setiyadi-ben/Project-Tugas-Akhir/readme.md

<div style="text-align: justify">

# Politeknik Negeri Semarang ( Polines )
# Digital Library Skripsi/Tugas Akhir ( Thesis ), Sarjana Terapan S.Tr Teknik Telekomunikasi 

## Dikembangkan oleh Benny Hartanto Setiyadi
### Bermitra dengan :
- Giarto sebagai Owner dari Rumah Maggot Kabupaten Semarang.
- ~~Ngadiyono sebagai Kepala Bagian dari Rumah Maggot Kabupaten Semarang.~~
- Gunardi sebagai Penanggung Jawab dari Rumah Maggot Kabupaten Semarang.
### Dibawah bimbingan :
- Ari Sriyanto N., S.T., M.T., M.Sc., ( Dosen Pembimbing I ).
- Sindung H.W.S., B.S.E.E, M.Eng.Sc., ( Dosen Pembimbing II ).
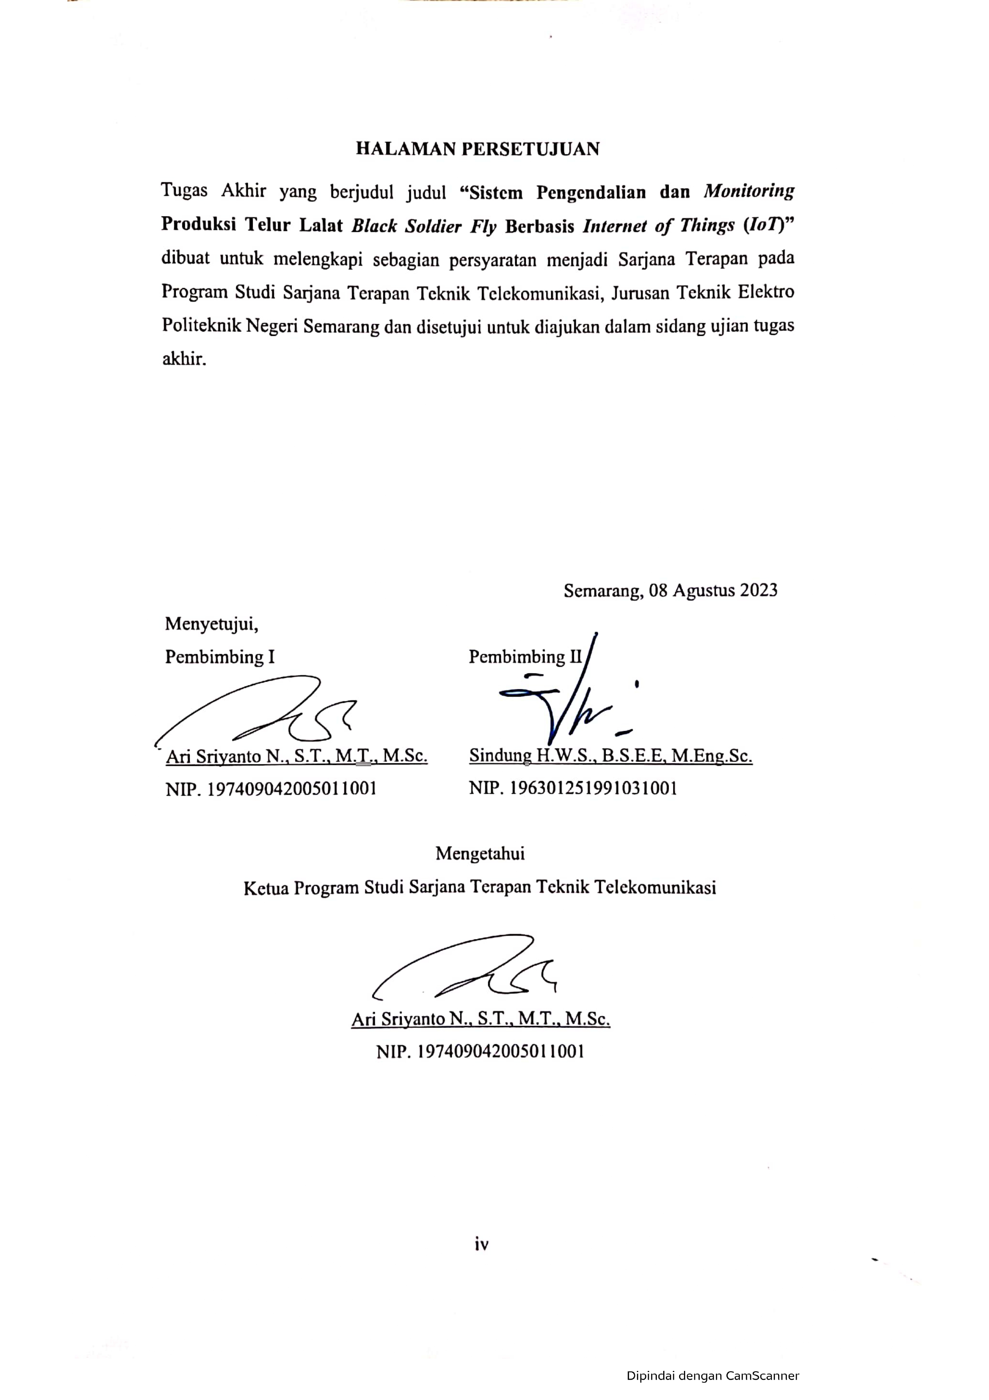
[picture p1: tugas_akhir/dokumenTA/Benny_TTD TA-2_persetujuan.jpg]


### Telah diuji oleh :
- Ir. Endro Wasito M. Kom ( Dosen Penguji I ).
- Drs. Arif Nursyahid, M.T ( Dosen Penguji II ).
- Abu Hasan, S.T., M.T ( Dosen Penguji III ).
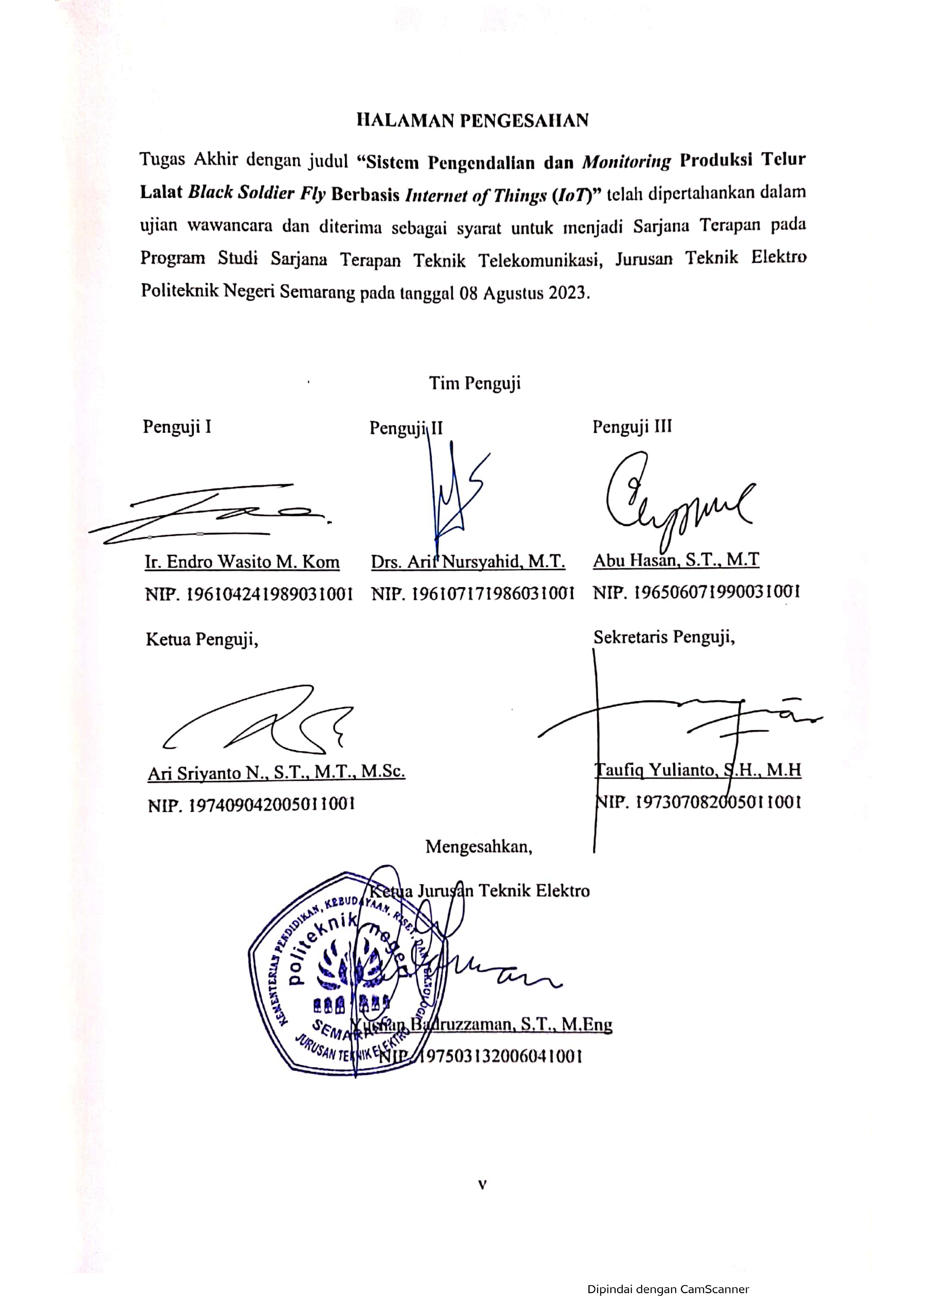
[picture p2: tugas_akhir/dokumenTA/Benny_TTD TA-3_pengesahan.jpg]


## Judul Tugas Akhir
  ### " Sistem Pengendalian dan Monitoring Produksi Telur Lalat Black Soldier Fly "

## Abstrak
<p align="justify"><i>
Benny Hartanto Setiyadi. “Sistem Pengendalian dan Monitoring Produksi Telur Lalat Black Soldier Fly Berbasis Internet of Things (IoT)”, Tugas Akhir Sarjana Terapan Teknik Telekomunikasi Jurusan Teknik Elektro Politeknik Negeri Semarang, dibawah bimbingan Ari Sriyanto N., S.T., M.T., M.Sc., dan Sindung H.W.S., B.S.E.E, M.Eng.Sc., 08 Agustus 2023, 54 Halaman. </p></i>
<p align="justify"><i>
Permasalahan sampah, termasuk sisa makanan, menjadi fokus penting di Indonesia dan negara lain. Pemerintah, terutama Kementerian Lingkungan Hidup dan Kehutanan, berupaya mengedukasi masyarakat dan Pengelola Tempat Pembuangan Akhir (TPA) untuk mengolah sampah sisa makanan menjadi pakan ternak alternatif. Larva lalat Black Soldier Fly (BSF) menawarkan potensi sebagai pengurai limbah sisa makanan yang efisien. Penelitian ini bertujuan merancang sistem IoT untuk mengendalikan dan memantau kondisi lingkungan kandang, dengan integrasi platform Telegram. Sistem ini mengontrol pompa air dan lampu fertilisasi, serta memiliki mode hybrid, yaitu manual menggunakan GPIO switch dan otomatis melalui bot Telegram. Dengan prototipe ini, penyemprotan air pada kandang lalat BSF dapat terjadwal secara otomatis melalui logika pemrograman pada bot Telegram, menghemat pemakaian air dibandingkan metode konvensional. Penggunaan aktuator lampu fertilisasi membantu lalat BSF beraktivitas normal saat intensitas cahaya rendah. Penelitian ini menggunakan metode Software Development Life Cycle model waterfall, meliputi tahap observasi, analisis kebutuhan, perancangan, implementasi, pengujian, dan analisis hasil. Hasil pengujian hardware membuktikan perangkat prototipe efektif mengendalikan aktuator secara manual dan otomatis melalui bot Telegram. Data hasil pengujian menunjukkan bahwa  rata – rata temperatur sebesar 32°C, kelembapan 60,8%, intensitas cahaya 15004lx menunjukkan standar lingkungan yang baik. Hasil dari telur yang diproduksi ialah berkisar dari 0,25 gram hingga 11 gram.</p></i>
<p align="justify"><i>
Kata kunci: Sampah Sisa Makanan, Lalat Black Soldier Fly, IoT, Telegram, Pengendalian Aktuator, Monitoring, Water pump, Lampu penyerbuk. </p></i>

## Dokumen Tugas Akhir :
Berikut merupakan dokumen - dokumen yang dibutuhkan pada saat membuat Tugas Akhir hingga dinyatakan selesai dan lulus hingga berhak untuk mengikuti wisuda pusat di Politeknik Negeri Semarang. 

<a href="/tugas_akhir/dokumenTA/daftarWisuda/[D4_TA]_BENNY HARTANTO S_TE4B_2023.pdf" target="_blank">`Laporan Tugas Akhir.pdf`</a> <a href="/tugas_akhir/dokumenTA/DIREVISI_LAPORAN_TA_BENNY2.docx" target="_blank">`Laporan Tugas Akhir.docx`</a> <a href="/tugas_akhir/dokumenTA/daftarWisuda/DIPAKAI_JURNAL_TA-ID.pdf" target="_blank">`Jurnal Tugas Akhir_ID.pdf`</a> <a href="/tugas_akhir/dokumenTA/daftarWisuda/DIPAKAI_JURNAL_TA-ID.docx" target="_blank">`Jurnal Tugas Akhir_ID.docx`</a> <a href="/tugas_akhir/dokumenTA/daftarWisuda/DIPAKAI_MANUALBOOK_TA.pdf" target="_blank">`Manualbook.pdf`</a>

<a href="/tugas_akhir/dokumenTA/Syarat Daftar Sidang.jpeg" target="_blank">`Syarat Daftar Sidang.jpeg`</a> <a href="/tugas_akhir/dokumenTA/Syarat Daftar Wisuda.jpeg" target="_blank">`Syarat Daftar Wisuda.jpeg`</a> <a href="/tugas_akhir/dokumenTA/Syarat mendapatkan SKL.pdf" target="_blank">`Syarat mendapatkan SKL/Transkrip.pdf`</a>

## Hasil Revisi Tugas Akhir :
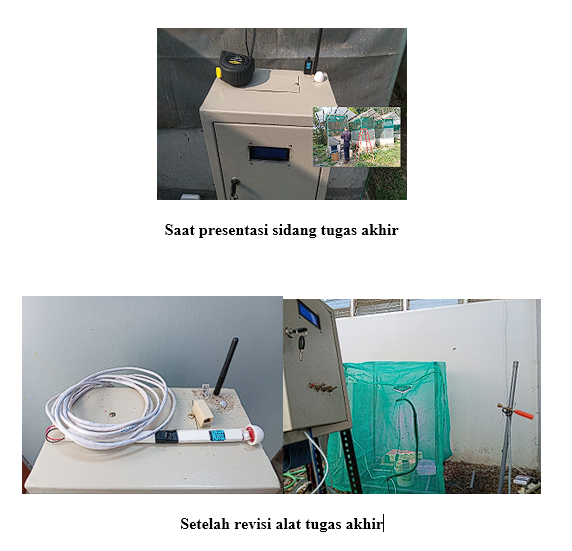
[picture p3: tugas_akhir/dokumenTA/hasilRevisi.png]


## Wiring Diagram

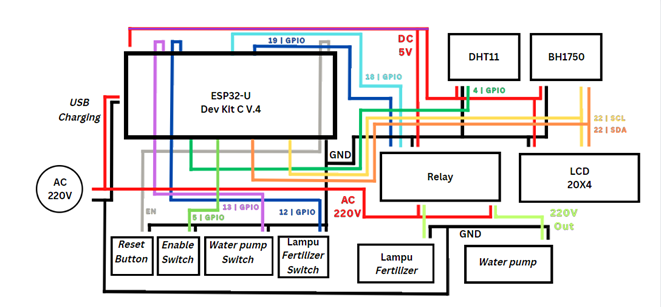
[picture p4: tugas_akhir/dokumenTA/wiringDiagram.png]

<!-- EMBED LOCAL FILE TIPS
https://www.seancdavis.com/posts/three-ways-to-add-image-to-github-readme/ -->

## Spesifikasi
- _Panel box dimensions_ (cm, cm, cm, cm).
- _Single_ 220VAC _power input splitted to_ ESP32, lampu _fertilizer_ dan _water pump_.
- 20x4 _LCD Display_.
- DHT11 _sensor_.
- BH1750 _sensor_.
- 2.4 GHz WiFi _antenna_ komunikasi.
- _Water pump_ 130PSi 12VDC dengan adapter AC.
- Lampu _fertilizer_ warna _bright purple_ dengan _female_ AC _jack_ 3 meter.
- _Manual GPIO Switch_ (_enable_, lampu _fertilizer_, _water pump_).
- _Reset Switch_

## Fitur - fitur :
- Mengendalikan kondisi _water pump_ ( LOW | HIGH ).
- Mengendalikan kondisi lampu _fertilizer_ ( LOW | HIGH ).
- Kendali _hybrid_ menggunakan perintah bot telegram maupun _Manual GPIO Switch_.
- Kendali kondisi otomatis melalui perintah _/schedule_ melalui bot telegram.
- _Monitoring_ suhu dan kelembapan melalui bot telegram dan layar _LCD_.
- _Monitoring_ intensitas cahaya melalui bot telegram dan layar _LCD_.
- Sistem dapat bekerja di saat internet putus sekalipun dengan syarat pada kondisi awal atau setelah reset pernah terhubung ke internet satu kali.

## Bugs :
- Saat koneksi internet _unstable_, terkadang akan memunculkan _duplicate messages_.
- ~~Saat proses _booting_, relay akan menyala di awal hingga program selesai dimuat (khusus untuk konfigurasi relay _Normally Close_ atau _NC_).~~
- Jika pesan balasan dari bot telegram lambat atau tidak muncul sama sekali perhatikan pada konfigurasi _antenna_ ESP32.
- Tidak bisa melayani request dalam jumlah banyak kecuali dengan cara bergantian.
- Tergantung dari kelancaran koneksi internet, _button_ kadang - kadang memerlukan 2 kali penekanan hingga dapat berfungsi.
- Perintah /schedule pada bot telegram kemungkinan akan terganggu jika koneksi WiFi terputus dikarenakan menggunakan sinkronisasi waktu _NTP_.
- ~~Masalah perintah _/switch_ pada bot telegram.~~
- ~~Masalah perintah _/schedule_ dimana aktuator tidak berhenti setelah perintah stop _button_ dijalankan.~~

## Playlist Video Sebelum Revisi (Klik Gambar dibawah)
<p align="center"><a href="https://www.youtube.com/playlist?list=PL8nDSUqXeZfUDnogHgag6RzNRzioCGDOZ">
  
</a></p>
<!-- EMBED YT PLAYLIST
https://bobbyhadz.com/blog/embed-video-into-github-readme-markdown -->

## Playlist Video Setelah Revisi (Klik Gambar dibawah)
<p align="center"><a href="https://www.youtube.com/playlist?list=PL8nDSUqXeZfWEAUHO0MUWcxwX7mzMBE_k">
  
</a></p>

## Requirements and How to Set-Up

**Saya anggap siapapun yang akan mencoba mempraktikkan atau berniat menggunakan kode ini sepenuhnya sadar dan memahami tentang pengkabelan jalur kabel seperti yang tertera pada _Wiring Diagram_, cara menggunakan Visual Studio Code beserta dengan ekstensi PlatformIO. Jika sudah, ikutilah langkah singkat dibawah ini atau bisa dengan membuka manualbook yang tertera di dokumen TA.**

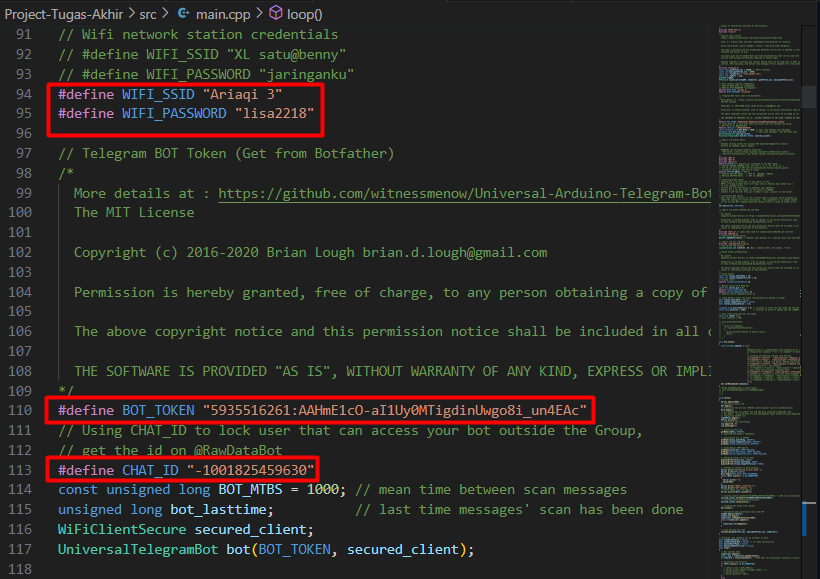
[picture p5: tugas_akhir/dokumenTA/setup.png]
pengabelan


Ubahlah parameter WIFI_SSID dan WIFI_PASSWORD sesuai dengan jaringan kalian. Kemudian juga pada BOT_TOKEN dan CHAT_ID, jika bertanya bagaimana? Kalian dapat mencarinya di Youtube sendiri terima kasih.

</div>
