setiyadi-ben/Project-Tugas-Akhir/tugas_akhir/datasheetKomponen/NOTES.txt

UNI-T 383 : 
- (DEMO VIDEO) https://www.youtube.com/watch?v=1Zy0yAb8VEA&t=86s
- (STORE PAGE) https://id.aliexpress.com/item/1005003141560128.html?
- (WEBSITE) https://meters.uni-trend.com/product/ut383-ut383bt/#Specifications

SMART SENSOR AS803 :
- (DEMO VIDEO) https://www.youtube.com/watch?v=disgpO15m7I
- (STORE PAGE) https://id.aliexpress.com/item/32792380083.html?
- (WEBSITE) https://en.smartsensor.cn/product/52.html
