setiyadi-ben/Project-Tugas-Akhir/tugas_akhir/dokumenTA/Pengumpulan Alat TA Fisik.docx

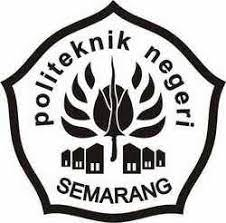
[picture p203: figure]

| PENGUMPULAN BENDA JADI ALAT TUGAS AKHIR | No. PM
| | Revisi
| | Tanggal
| | Halaman

N A M A KELAS NIM | : Benny Hartanto Setiyadi : TE-4B : 4.39.19.0.06 | JUDUL TUGAS AKHIR : “Sistem Pengendalian dan Monitoring Produksi Telur Lalat Black Soldier Fly” PETUNJUK PENGGUNAAN : - Manual book - Online repo : https://github.com/setiyadi-ben/Project-Tugas-Akhir
