setiyadi-ben/Project-Tugas-Akhir/tugas_akhir/dokumenTA/DIUPLOAD-DIREVISI_LAPORAN_TA_BENNY2.pdf

TUGAS AKHIR

SISTEM PENGENDALIAN DAN MONITORING

PRODUKSI TELUR LALAT BLACK SOLDIER FLY

BERBASIS INTERNET OF THINGS (IoT)

Tugas Akhir ini diajukan untuk memenuhi persyaratan untuk menjadi

Sarjana Terapan pada Program Studi S.Tr Teknik Telekomunikasi

Jurusan Teknik Elektro Politeknik Negeri Semarang


Disusun oleh :

BENNY HARTANTO SETIYADI

4.39.19.0.06

PROGRAM STUDI SARJANA TERAPAN TEKNIK TELEKOMUNIKASI

JURUSAN TEKNIK ELEKTRO

POLITEKNIK NEGERI SEMARANG

2023

ii

TUGAS AKHIR

SISTEM PENGENDALIAN DAN MONITORING

PRODUKSI TELUR LALAT BLACK SOLDIER FLY

BERBASIS INTERNET OF THINGS (IoT)

Tugas Akhir ini diajukan untuk memenuhi persyaratan untuk menjadi

Sarjana Terapan pada Program Studi S.Tr Teknik Telekomunikasi

Jurusan Teknik Elektro Politeknik Negeri Semarang

Disusun oleh :

BENNY HARTANTO SETIYADI

4.39.19.0.06

PROGRAM STUDI SARJANA TERAPAN TEKNIK TELEKOMUNIKASI

JURUSAN TEKNIK ELEKTRO

POLITEKNIK NEGERI SEMARANG

2023

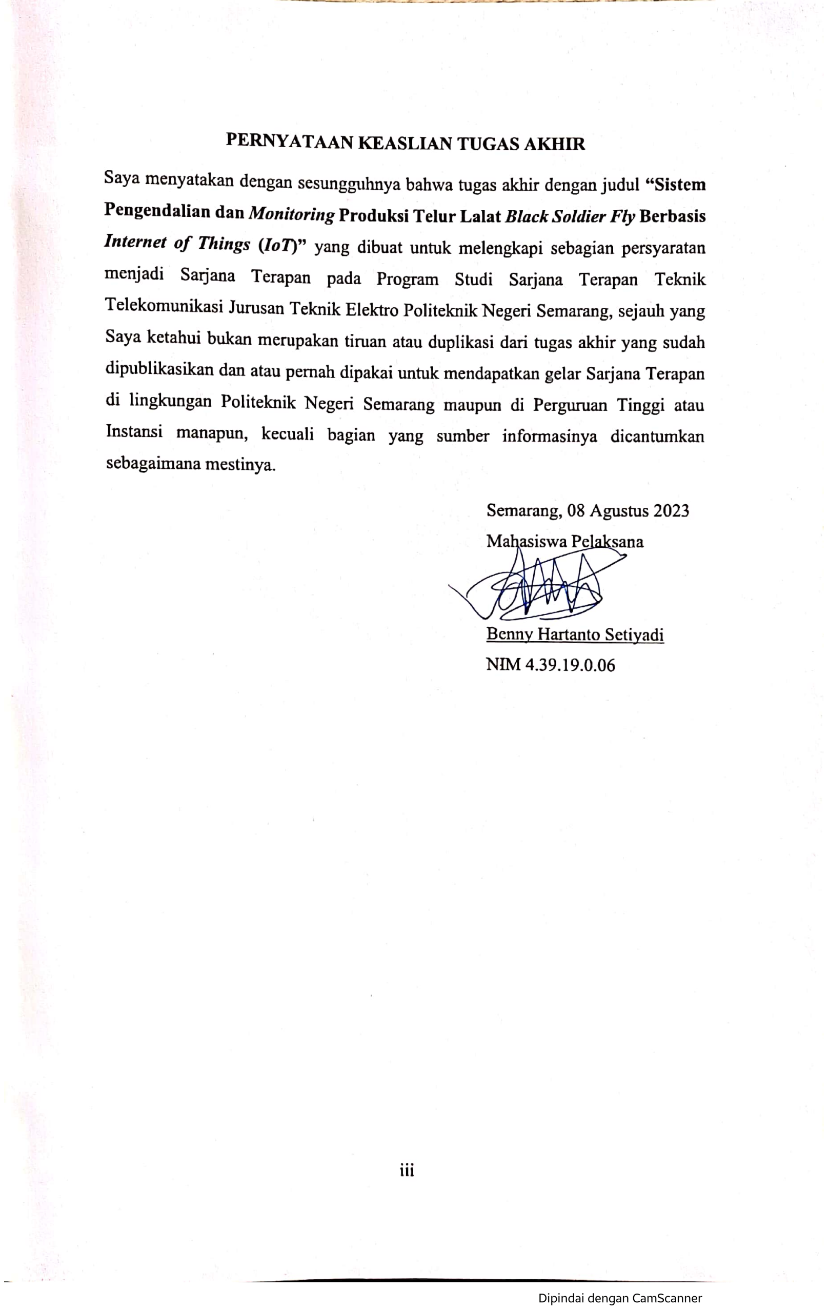
[picture p264: page 3]
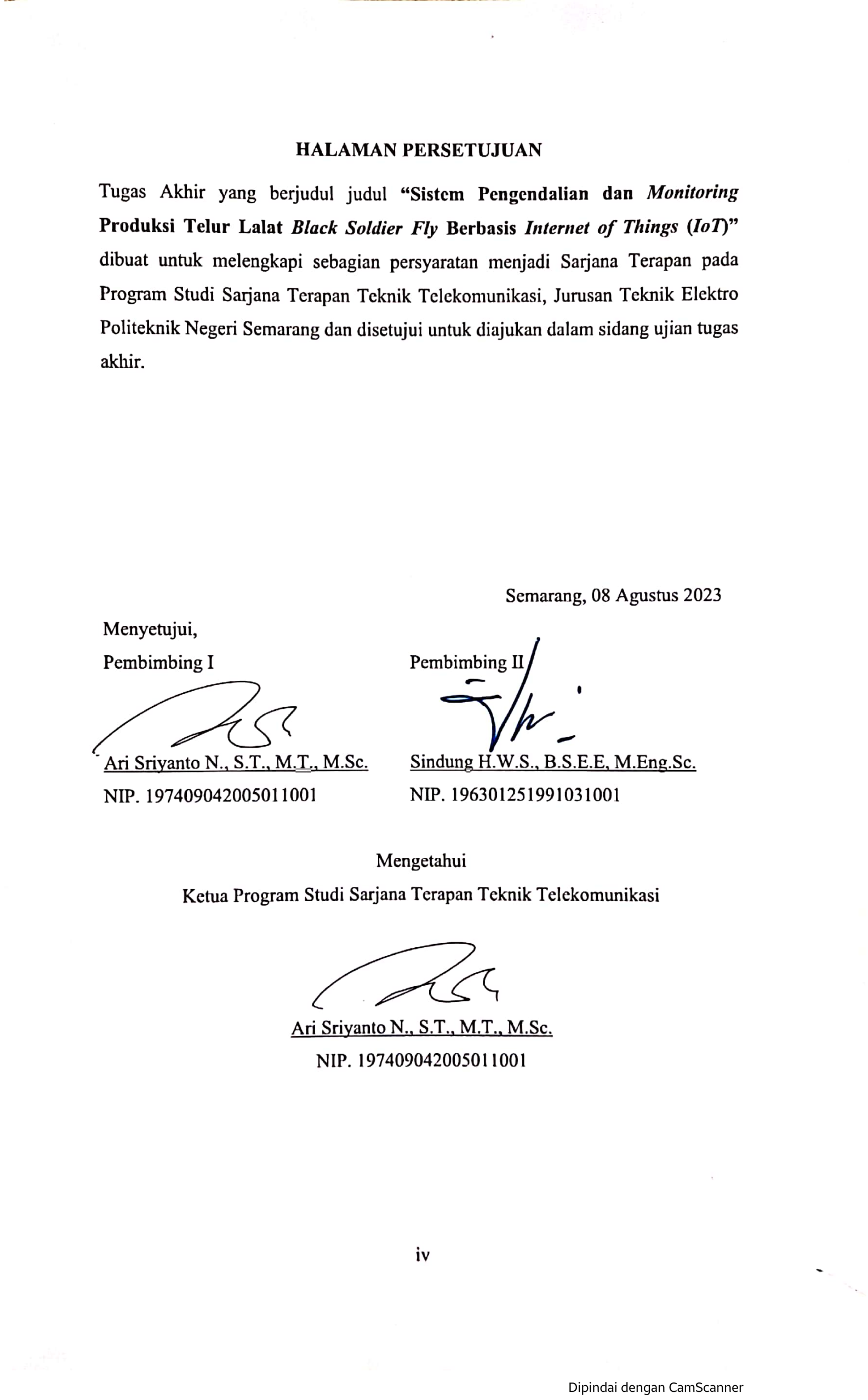
[picture p265: page 4]
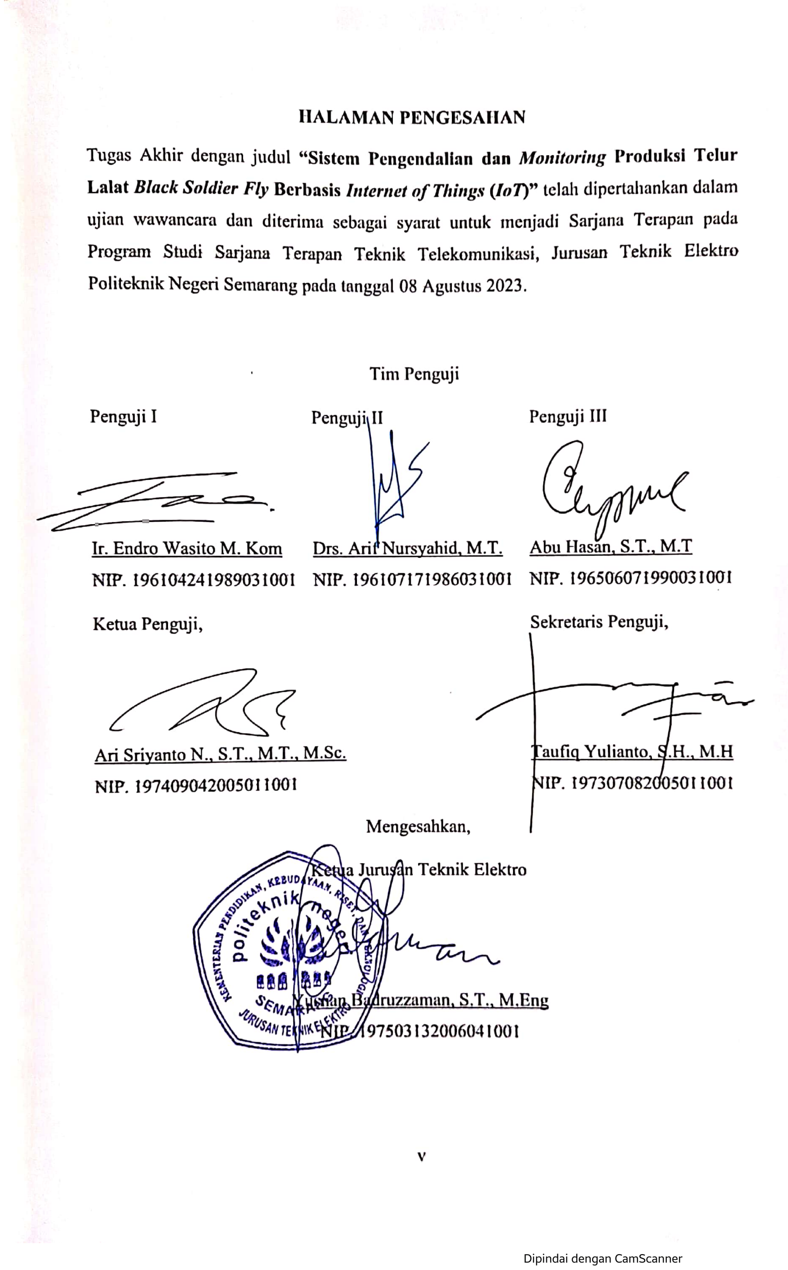
[picture p266: page 5]

vi

KATA PENGANTAR

Puji syukur kehadirat Tuhan Yang Maha Esa, yang telah memberikan rahmat dan

hidayah-Nya sehingga penulis dapat menyelesaikan tugas akhir dengan judul

“Sistem Pengendalian dan Monitoring Produksi Telur Lalat Black Soldier Fly

Berbasis Internet of Things (IoT)” tugas akhir ini merupakan salah satu

persyaratan untuk menjadi Sarjana Terapan pada Program Studi S.Tr Teknik

Telekomunikasi Jurusan Teknik Elektro Politeknik Negeri Semarang.

Dalam pelaksanaan dan penyelesaian laporan tugas akhir ini penulis dibantu oleh

banyak pihak. Oleh karena itu, penulis mengucapkan terima kasih kepada :

1. Allah SWT.
2. Bapak Prof., Dr., Totok Prasetyo., B.Eng (Hons)., MT., IPU.,

ASEAN.Eng., ACPE., selaku Direktur Politeknik Negeri Semarang.

3. Bapak Yusnan Badruzzaman, S.T., M.Eng., selaku Ketua Jurusan Teknik

Elektro.

4. Bapak Ari Sriyanto N., S.T., M.T., M.Sc., selaku Ketua Prodi S.Tr Teknik

Telekomunikasi dan merangkap menjadi Pembimbing I yang telah banyak

berjasa, membantu, mendukung penuh dan membimbing Saya dalam

menyelesaikan tugas akhir ini.

5. Bapak Sindung H.W.S., B.S.E.E, M.Eng.Sc., selaku Pembimbing II yang

telah banyak berjasa, membantu, mendukung penuh dan membimbing

Saya dalam menyelesaikan tugas akhir ini.

6. Bapak, Ibu dosen, dan staff teknik Prodi S.Tr Teknik Telekomunikasi

Politeknik Negeri Semarang.

7. Bapak, Ibu, dan semua keluarga Penulis yang selalu memberikan dukungan

dan doa yang tulus.

8. Teman beserta sahabat yang melakukan studi didalam Prodi S.Tr Teknik

Telekomunikasi Politeknik Negeri Semarang angkatan 2019.

Semarang, 08 Agustus 2023

Penulis

vii

ABSTRAK

Benny Hartanto Setiyadi. “Sistem Pengendalian dan Monitoring Produksi Telur

Lalat Black Soldier Fly Berbasis Internet of Things (IoT)”, Tugas Akhir Sarjana

Terapan Teknik Telekomunikasi Jurusan Teknik Elektro Politeknik Negeri

Semarang, dalam bimbingan Ari Sriyanto N., S.T., M.T., M.Sc., dan Sindung

H.W.S., B.S.E.E, M.Eng.Sc., 08 Agustus 2023, 54 Halaman.

Permasalahan sampah, termasuk sisa makanan, menjadi fokus penting di Indonesia dan negara

lain. Pemerintah, terutama Kementerian Lingkungan Hidup dan Kehutanan, berupaya mengedukasi

masyarakat dan Pengelola Tempat Pembuangan Akhir (TPA) untuk mengolah sampah sisa

makanan menjadi pakan ternak alternatif. Larva lalat Black Soldier Fly (BSF) menawarkan potensi

sebagai pengurai limbah sisa makanan yang efisien. Penelitian ini bertujuan merancang sistem IoT

untuk mengendalikan dan memantau kondisi lingkungan kandang, dengan integrasi platform

Telegram. Sistem ini mengontrol pompa air dan lampu fertilisasi, serta memiliki mode hybrid, yaitu

manual menggunakan GPIO switch dan otomatis melalui bot Telegram. Dengan prototipe ini,

penyemprotan air pada kandang lalat BSF dapat terjadwal secara otomatis melalui logika

pemrograman pada bot Telegram, menghemat pemakaian air dibandingkan metode konvensional.

Penggunaan aktuator lampu fertilisasi membantu lalat BSF beraktivitas normal saat intensitas

cahaya rendah. Penelitian ini menggunakan metode Software Development Life Cycle model

waterfall, meliputi tahap observasi, analisis kebutuhan, perancangan, implementasi, pengujian, dan

analisis hasil. Hasil pengujian hardware membuktikan perangkat prototipe efektif mengendalikan

aktuator secara manual dan otomatis melalui bot Telegram. Data hasil pengujian menunjukkan

bahwa rata – rata temperatur sebesar 32°C, kelembapan 60,8%, intensitas cahaya 15004lx

menunjukkan standar lingkungan yang baik. Hasil dari telur yang diproduksi ialah berkisar dari

0,25 gram hingga 11 gram.

Kata kunci: Sampah Sisa Makanan, Lalat Black Soldier Fly, IoT, Telegram,

Pengendalian Aktuator, Monitoring, Water pump, Lampu penyerbuk.

viii

ABSTRACT

Benny Hartanto Setiyadi. "Control and Monitoring System for Black Soldier Fly

Egg Production based on Internet of Things (IoT)," Undergraduate Thesis in

Applied Telecommunication Engineering, Department of Electrical Engineering,

State Polytechnic of Semarang, under the guidance of Ari Sriyanto N., S.T., M.T.,

M.Sc., and Sindung H.W.S., B.S.E.E, M.Eng.Sc., August 08, 2023, 54 Pages.

The issue of waste, including food scraps, is a significant concern in Indonesia and other countries.

The government, particularly the Ministry of Environment and Forestry, strives to educate the public

and Waste Disposal Site Managers (TPA) about converting food waste into alternative animal feed.

Larvae of the Black Soldier Fly (BSF) offer the potential for efficient decomposition of food waste.

This research aims to design an IoT system to control and monitor the environmental conditions

inside the breeding chamber, utilizing the waterfall model in the Software Development Life Cycle.

The system controls the water pump and fertilization lamp, with hybrid modes available: manual

operation via GPIO switch and automatic operation through the Telegram bot. With this prototype,

automated scheduling of water spraying in the BSF chamber is achieved using Telegram's

programming logic, resulting in water conservation compared to conventional methods. The use of

the fertilization lamp actuator aids in maintaining normal BSF activity under low light conditions.

This study employs the Software Development Life Cycle waterfall model, encompassing stages of

observation, requirement analysis, design, implementation, testing, and result analysis. Hardware

testing results demonstrate the prototype device's effectiveness in manually and automatically

controlling actuators through the Telegram bot. Test data indicates an average temperature of 32°C,

humidity of 60.8%, and light intensity of 15004lx, signifying a satisfactory environmental standard.

The produced egg yields range from 0.25 grams to 11 grams..

Keywords: Food Scraps, Black Soldier Fly, IoT, Telegram, Actuator Control,

Monitoring, Fertilizer Light.

ix

DAFTAR ISI

x

xi

DAFTAR GAMBAR

Gambar 1.1 Metode SDLC model waterfall pada penelitian tugas akhir (Sumber :

Gambar 2.1 Lalat Black Soldier Fly (Sumber : Dinas Pertanian dan Ketahanan

Gambar 2.2 Siklus Hidup Lalat Black Soldier Fly (Sumber : Tomberlin et al.

Gambar 2.3 The Botfather, layanan untuk membuat dan mengelola akun bot

Gambar 2.4 ESP32 Mikrokontroler dengan external antenna (Sumber :

Gambar 2.5 Sensor BH1750 (Sumber : https://tokopedia.link/wxJ0pAOjsub).... 14

Gambar 2.6 Digital Lux Light Meter (Sumber :

Gambar 2.7 Sensor DHT11 (Sumber : https://tokopedia.link/hOzuF1Cosub) ..... 16

Gambar 2.8 Alat ukur temperatur (Sumber :

https://www.tokopedia.com/anugerahmed-mlg/thermometer-hygrometer-digital-

Gambar 2.9 Alat ukur temperatur (Sumber :

Gambar 2.17 Grow Light (Sumber:

xii

Gambar 3.3 Mekanisme sistem dalam flowchart bagian – 1 (Dok. Penulis)........ 25

Gambar 3.4 Mekanisme sistem dalam flowchart bagian – 2 (Dok. Penulis)........ 26

Gambar 3.6 Simulasi program menggunakan koneksi serial (Dok. Penulis) ....... 28

Gambar 3.11 Hasil rancang bangun perangkat prototipe sistem IoT (Dok. Penulis)

Gambar 3.14 Perangkat terkendali water pump pada perangkat prototipe (Dok.

Gambar 3.16 Aplikasi penggunaan bot telegram bagian – 1 (Dok. Penulis)........ 34

Gambar 3.14 Aplikasi penggunaan bot telegram bagian – 2 (Dok. Penulis)........ 34

Gambar 3.15 Aplikasi penggunaan bot telegram bagian – 3 (Dok. Penulis)........ 35

Gambar 3.16 Aplikasi penggunaan bot telegram bagian – 4 (Dok. Penulis)........ 35

Gambar 4.5 Pemantauan realtime cuaca dengan pancaindra (Dok. Pengujian

Gambar 4.6 Jumlah produksi telur dalam satuan miligram (Dok. Pengujian

Gambar 4.7 Balok kayu tempat lalat BSF bertelur (Dok. Pengujian Penulis)...... 48

xiii

DAFTAR TABEL

Tabel 4.5 Pengujian lapangan atau field testing tanpa interaksi oleh perangkat

Tabel 4.6 Pengujian lapangan atau field testing dengan interaksi oleh perangkat

BAB I

PENDAHULUAN

### 1.1. Latar Belakang

Permasalahan mengenai sampah merupakan sebuah permasalahan yang dialami

oleh semua negara baik negara maju maupaun negara berkembang seperti

contohnya Indonesia. Menurut Undang-Undang Republik Indonesia Nomor 18

Tahun 2008 Tentang Pengelolaan Sampah, yang dimaksud sampah adalah sisa

kegiatan sehari-hari manusia dan/atau proses alam yang berbentuk padat. Sampah

ini dihasilkan manusia setiap melakukan aktivitas sehari-hari.

Adapun jenis sifat sampahnya, dapat dikategorikan menjadi 2 yaitu, sampah

organik dan sampah anorganik. Sampah organik merupakan sampah yang dapat

membusuk dan dapat terurai oleh lingkungan dengan bantuan hewan maupun

serangga pengurai. Sedangkan, sampah anorganik tidak dapat terurai oleh

lingkungan dengan cara yang sesingkat sampah organik, sampah ini membutuhkan

waktu ribuan tahun hingga dapat terurai menjadi tanah. Oleh sebab itu, sampah

anorganik harus dikumpulkan untuk diolah kembali (didaur ulang) menjadi benda

yang sama atau menjadi benda berbeda yang dapat digunakan kembali oleh

manusia.

Berdasarkan data dari Kementerian Lingkungan Hidup dan Kehutanan (KLHK)

mencatat, Indonesia menghasilkan sampah sebanyak 21,88 juta ton pada 2021.

Jumlah itu menurun 33,33% dibandingkan pada tahun sebelumnya yang sebanyak

32,82 juta ton. Kondisi tersebut berbeda dengan tahun 2020 yang jumlah

sampahnya justru meningkat 12,63%. Sementara, jumlah timbulan sampah pada

2019 sebanyak 29,14 juta ton. Berdasarkan wilayahnya, Jawa Tengah menjadi

provinsi dengan sampah terbesar di Indonesia pada 2021, yakni 3,65 juta ton.

Posisinya disusul oleh Jawa Timur dengan sampah sebanyak 2,64 juta ton (Mahdi

& Bayu, 2021).

Menurut data dari SIPSN (Sistem Informasi Pengelolaan Sampah Nasional) pada

tahun 2021, diketahui bahwa komposisi jenis sampah terbesar disumbang oleh jenis sisa makanan sebesar 40.1% kemudian disusul oleh plastik 17.5%, kayu 13%,

kertas 11.9% dan 17.5% jenis sampah lainnya (SIPSN, 2022).

Dengan begitu banyaknya sampah dari jenis sisa makanan ini menjadi fokus

penting Pemerintah khususnya Kementerian Lingkungan Hidup dan Kehutanan

(KLHK) dalam mengedukasikan solusi kepada para masyarakat umum maupun

Pengelola Tempat Pembuangan Akhir (TPA) untuk mengolah sampah sisa

makanan tersebut menjadi produk organik yang dapat dimanfaatkan sebagai sumber

pakan ternak alternatif.

Adapun sumber pakan ternak yang dimaksud adalah larva atau maggot dari

serangga Lalat Black Soldier Fly atau BSF (dalam bahasa latin: Hermetia illucens

L) atau yang sering disebut dengan lalat tentara hitam. Lalat BSF ini mampu

mengurai limbah sisa makanan dalam waktu beberapa hari saja tergantung dengan

berapa besar kandang tempat lalat tersebut ditempatkan. Saat menuju fase prepupa

hingga menjadi lalat BSF dewasa, lalat tersebut akan berhenti makan dan lalat

tersebut akan mati setelah selesai bereproduksi (kawin) untuk lalat pejantan dan

mati setelah bertelur untuk lalat betina.

Pada saat fase reproduksi didapatkan bukti bahwa terdapat lalat yang sudah mati

lebih awal sebelum melakukan kegiatan reproduksi. Hal ini secara umum

disebabkan oleh 2 faktor penting yaitu, lalat yang tidak mendapatkan minum secara

rutin dikarenakan mereka sudah berhenti makan dan hanya meminum partikel air

di fase prepupa ditambah dengan faktor kesediaan intensitas cahaya sinar cahaya

matahari yang kurang cerah menyebabkan kegiatan lalat BSF dalam melakukan

proses reproduksi berkurang. Dijelaskan bahwa panjang gelombang 450-700 nm

berpengaruh terhadap tingkah laku kawin lalat BSF, sedangkan pada panjang

gelombang 350-450 nm tidak menstimulasi terjadinya aktivitas kawin BSF.

Panjang gelombang cahaya yang masih dapat dilihat oleh inseksta sekitar 700 nm

(Briscoe & Chittka, 2001).

Permasalahan berupa penyediaan air minum dan penyediaan intensitas cahaya

inilah yang menjadi fokus penting dalam pembuatan suatu sistem yang dapat

menyelesaikan kebutuhan dari lalat BSF untuk melakukan kegiatan reproduksi.

Dengan kata lain teknologi tersebut diharapkan mampu untuk secara otomatis maupun manual untuk dikonfigurasi (bersifat hybrid) menggunakan smartphone

melalui jaringan internet agar nantinya dapat menyediakan kondisi lingkungan di

dalam kandang yang ideal. Sehingga, lalat BSF dapat menghasilkan jumlah telur

dengan lebih baik jika dibandingkan dengan cara konvensional.

Internet of Things (IoT) merupakan sebuah konsep di mana suatu benda atau objek

ditanamkan teknologi-teknologi seperti sensor dan software dengan tujuan untuk

berkomunikasi, mengendalikan, menghubungkan, dan bertukar data melalui

perangkat lain selama masih terhubung ke internet. IoT memiliki hubungan yang

erat dengan istilah machine-to-machine atau M2M. Seluruh alat yang memiliki

kemampuan komunikasi M2M ini sering disebut dengan perangkat cerdas atau

smart devices. Perangkat cerdas ini diharapkan dapat membantu kerja manusia

dalam menyelesaikan berbagai urusan atau tugas yang ada (Setiawan, 2021b).

### 1.2. Tujuan

Adapun tujuan dari pembuatan tugas akhir ini adalah :

1. Membuat rancang bangun sistem IoT untuk pengendalian dan monitoring

produksi telur lalat BSF pada kandangnya dengan integrasi platform telegram.

2. Rancang bangun sistem tersebut dapat mengendalikan kondisi water pump.
3. Rancang bangun sistem tersebut dapat mengendalikan kondisi lampu fertilizer.
4. Rancang bangun sistem tersebut bersifat hybrid yang artinya memiliki

kemampuan untuk bertransisi dari manual mode ke automatic mode dan

sebaliknya.

### 1.3. Perumusan Masalah

Dari berbagai tujuan di atas, dapat dijadikan sebagai landasan untuk menyelesaikan

masalah berupa :

1. Bagaimana membuat sistem pengendalian dan monitoring untuk kandang lalat

BSF yang dapat mengendalikan kondisi water pump dan lampu fertilizer

terintegrasi oleh platform telegram dengan kemampuan hybrid.

### 1.4. Batasan Masalah

Dari pembuatan tugas akhir ini, fokus yang dapat dijadikan sebagai pedoman

pengentasan masalah berupa :

1. Topik dari tugas akhir ini akan berfokus pada lalat BSF dewasa yang memasuki

masa reproduksi hingga bertelur mengenai metode perawatan yang akan

dikendalikan oleh sistem yang akan dibuat.

2. Produk yang dihasilkan akan berupa sebuah prototipe yang bersifat hybrid agar

dapat dikonfigurasi baik secara otomatis maupun manual.

3. Permintaan dari user yang menginginkan agar sistem yang dibuat agar dapat

mudah dikendalikan bahkan pada saat kondisi internet terputus.

4. Adapun parameter yang dapat dikonfigurasi berupa air pada water pump dan

cahaya pada lampu fertilizer

5. Adapun prototipe tersebut akan berbentuk sebuah panel box yang terdiri dari

rangkaian komponen elektronika dengan ESP32 sebagai otaknya, DHT11 dan

BH1750 sebagai sensor, sedangkan relay sebagai aktuator yang mengatur

perangkat terkendali water pump dan lampu fertilizer.

6. Khusus untuk sensor BH1750 hanya akan digunakan sebagai pendeteksi naik

dan turunnya nilai intensitas cahaya untuk merubah kondisi perangkat

terkendali lampu fertilizer. Dikarenakan hasil dari pembacaan sensor readings

memiliki standarisasi penilaian yang berbeda dengan alat ukur mini light meter

membuat nilai yang dihasilkan memiliki selisih nilai yang acak dan tidak

beragam.

7. Prototipe tersebut terhubung dengan bot pada platform telegram yang hanya

dapat diakses oleh pengguna telegram yang bergabung pada grup “Maggot BSF

Kab. Semarang” sebagai upaya preventif dari serangan oleh pihak yang tidak

bertanggungjawab.

### 1.5. Metodologi Penelitian

Metode penelitan yang digunakan dalam penyusunan tugas akhir ini yaitu metode

penelitian Software Development Life Cycle model waterfall. Metode SDLC sendiri

adalah proses pembuatan dan pengubahan sistem serta model dan metodologi yang

digunakan untuk mengembangkan sistem rekayasa perangkat lunak dalam pengembangan produk. Sedangkan model waterfall adalah metode kerja yang

menekankan fase-fase yang berurutan dan sistematis. Disebut waterfall karena

proses mengalir satu arah “ke bawah” seperti air terjun. Metode waterfall ini harus

dilakukan secara berurutan sesuai dengan tahap yang ada (Setiawan, 2021a).

Alur dari penelitian tugas akhir dapat digambarkan pada gambar 1.1 sebagai berikut

:


Gambar 1.1 Metode SDLC model waterfall

pada penelitian tugas akhir (Sumber : Dok. Penulis)

Berikut ini merupakan penjelasan dari alur SDLC model waterfall :

1. Observasi

Kegiatan dilakukan dengan cara kunjungan secara langsung dengan mengamati

kondisi lingkungan budidaya lalat BSF di tempat user atau mitra usaha di TPA

Blondo, Kabupaten Semarang untuk mengumpulkan data – data yang

diperlukan pada pembuatan tugas akhir.

2. Analisa Kebutuhan

Tahapan ini merupakan kelanjutan dari proses observasi untuk merencanakan

beberapa hal yang terkait dengan kebutuhan yang diinginkan oleh user,

teknologi yang akan dipakai, anggaran yang dikeluarkan dan lain – lain.

3. Perancangan

Pada tahap perancangan, penerapan teknologi diterapkan mulai dari arsitektur

sistem secara keseluruhan yang didalamnya arsitektur hardware yang

didalamnya terdapat rangkaian komponen elektronika yang digambarkan dalam

wiring diagram beserta flowchart dan arsitektur software yang menjelaskan

bagaimana sistem dapat beroperasi dan melakukan komunikasi dengan platform

telegram agar dapat dikonfigurasi.

4. Implementasi

Tahapan ini merupakan penerapan dari tahap perancangan dimana setiap model

– model rancangan dikerjakan hingga membentuk sebuah perangkat prototipe

yang dapat dioperasikan secara hybrid.

5. Uji lapangan

Pengujian pada lapangan untuk membuktikan keandalan sistem pada perangkat

prototipe beserta keakuratan pembacaan sensor readings untuk dibandingkan

dengan kondisi awal pemanenan telur lalat BSF tanpa interaksi perangkat

prototipe.

6. Analisis Hasil

Merupakan tahapan akhir dimana data – data hasil pengujian yang telah

dilakukan pada tahap uji lapangan dilakukan proses interpretasi untuk

memperoleh jawaban dalam bentuk ilmiah yang mudah dipahami, dapat

dipertanggung jawabkan serta dapat disimpulkan.

### 1.6. Sistematika Penulisan

Dalam penyusunan tugas akhir ini dilakukan pengelompokkan menurut isi dalam

beberapa bab. Bagian yang dapat berdiri sendiri dipisahkan dengan bagian yang

lain dan ditempatkan dalam bab tersendiri dengan maksud mempermudah

pemahaman. Adapun sistematika penulisannya adalah sebagai berikut:

BAB I : PENDAHULUAN

Bab I Pendahuluan berisi tentang latar belakang, perumusan masalah, manfaat,

tujuan yang diharapkan, batasan masalah dan sistematika penulisan laporan tugas

akhir.

BAB II : TINJAUAN PUSTAKA

Bab II Tinjauan Pustaka berisi tentang penjelasan mengenai teori–teori penunjang

yang dijadikan landasan dalam mengerjakan tugas akhir.

BAB III : KEGIATAN PELAKSANAAN

Bab III Kegiatan Pelaksanaan berisi tentang tahap perancangan, tahap pembuatan,

dan cara kerja alat yang dibuat.

BAB IV : ANALISIS DAN PEMBAHASAN

Bab IV Analisis dan Pembahasan berisi tentang pembahasan hasil percobaan, serta

pembahasan analisa hasil percobaan.

BAB V : KESIMPULAN

Bab V Kesimpulan berisi tentang kesimpulan secara keseluruhan dari hasil analisis

dan saran dalam rangka memperbaiki dan menyempurnakan tugas akhir.

DAFTAR PUSTAKA

Daftar Pustaka berisi sumber-sumber, jurnal, studi pustaka, yang penulis cantum

dalam proses penyelesaian tugas akhir ini.

LAMPIRAN

Lampiran berisi data atau pelengkap atau hasil olahan yang menunjang penulisan

laporan tugas akhir tetapi tidak dicantumkan di dalam isi tugas akhir, karena akan

menggangu kesinambungan penulisan.

BAB II

DASAR TEORI

### 2.1. Tinjauan Pustaka

Dalam pembuatan tugas akhir ini, untuk membuat alat yang memiliki sistem dengan

fitur pengendalian dan monitoring, diperlukan kajian mendalam mengenai relasi

antara suatu penelitian sebelumnya dengan penelitian yang sedang dibuat. Idealnya

hal ini berguna untuk melihat kekurangan dan kelebihan pada penelitian yang telah

dilakukan sebelumnya yang bisa bersumber dari jurnal ilmiah maupun buku – buku

tertentu. Selain kelebihan dan kekurangan, hal lain yang dapat dijadikan sebagai

rujukan berupa: teknologi yang dipakai, tambahan materi yang didapat, parameter

hasil pengujian dan masih banyak lagi.

Setelah mengetahui tujuan dari tinjauan pustaka di atas, pada tabel 2.1 merupakan

beberapa hasil yang telah dijadikan sebagai rujukan dalam pembuatan “ Sistem

Pengendalian dan Monitoring Produksi Telur Lalat Black Soldier Fly ”.

Tabel 2.1 Tabel rujukan tinjauan pustaka untuk pembuatan sistem

No | Nama Artikel | Deskripsi Penelitian | Keterangan
1. Black Soldier Fly | rearing with artificial light: how to ensure mating success and fertile eggs (Swiss Federal Institute of Aquatic Science and Technology, Eawag) | Proses pengujian BSF dengan menggunakan artifical lights SolarRaptor untuk menguji faktor efisiensi aktivitas reproduksi | Pengujian dilakukan didalam fasilitas riset Eawag di Switzerland menggunakan beragam lampu yang berbeda untuk mengetahui efek lampu buatan terhadap aktifitas reproduksi BSF
2. Black Soldier Fly | (Hermetia illucens) sebagai Sumber Protein Alternatif untuk Pakan | Pengumpulan fakta – fakta dari penelitian terdahulu mengenai morfologi dan siklus hidup, kandungan | Fakta – fakta yang dikumpulkan tersebut men jadi sebuah data yang dapat menjelaskan lengkap secara detail mengenai

Ternak (April Hari

Wardhana, 2017)

nutrisi, pemanfaatan

sebagai pakan ternak

serta analisis ekonomi

pada BSF

BSF serta manfaat yang

dapat diperoleh manusia

3. Automated IoT Device to

Manipulate

Environmental

Condition of Black

Soldier Fly (Kevin

Kristianto, Ronaldo

Vieri Lambert, Abba

Suganda Girsang. Maret,

2022)

Memanipulasi kondisi

ruangan tempat BSF

berada untuk

memaksimalkan

produksi telur dengan

menggunakan sensor

BH1750 dan DHT11

dengan output berupa

warm bulb dan

exhaust fan.

Pembahasan penjelasan

menjelaskan tentang tabel

pengujian | keadaan

ruangan yang dipasang

dengan output dan ruangan

yang tidak ada outputnya.

Serta hasil telur yang telah

dihasilkan.

### 2.2. Landasan Teori

Dalam pembuatan tugas akhir ini, terdapat teori – teori yang menjadi pendukung

atau yang menjadi landasan untuk membangun alat dengan sistem yang

direncanakan, antara lain:

### 2.2.1. Black Soldier Fly


Gambar 2.1 Lalat Black Soldier Fly

(Sumber : Dinas Pertanian dan Ketahanan Pangan Provinsi Bali) (https://distanpangan.baliprov.go.id/)

Black Soldier Fly (BSF), lalat tentara hitam (Hermetia illucens, Diptera:

Stratiomyidae) pada gambar 2.1 adalah salah satu insekta yang mulai banyak dipelajari karakteristiknya dan kandungan nutriennya. Lalat ini berasal dari

Amerika dan selanjutnya tersebar ke wilayah subtropis dan tropis di dunia. (Čičková et al., 2015). Kondisi iklim tropis Indonesia sangat ideal untuk budidaya

BSF. Ditinjau dari segi budidaya, BSF sangat mudah untuk dikembangkan dalam

skala produksi massal dan tidak memerlukan peralatan yang khusus. Tahap akhir

larva (prepupa) dapat bermigrasi sendiri dari media tumbuhnya sehingga

memudahkan untuk dipanen. Selain itu, lalat ini bukan merupakan lalat hama dan

tidak dijumpai pada pemukiman yang padat penduduk sehingga relatif aman jika

dilihat dari segi kesehatan manusia. (Li et al., 2011)

Dari berbagai insekta yang dapat dikembangkan sebagai pakan, kandungan protein

larva BSF cukup tinggi, yaitu 40-50% dengan kandungan lemak berkisar 29-32%.

(Bosch et al., 2014). (Rambet et al., 2015) menyimpulkan bahwa tepung BSF

berpotensi sebagai pengganti tepung ikan hingga 100% untuk campuran pakan

ayam pedaging tanpa adanya efek negatif terhadap kecernaan bahan kering (57,96-

60,42%), energi (62,03-64,77%) dan protein (64,59-75,32%), walaupun hasil yang

terbaik diperoleh dari penggantian tepung ikan hingga 25% atau 11,25% dalam

pakan.


Gambar 2.2 Siklus Hidup Lalat Black Soldier Fly

(Sumber : Tomberlin et al. (2002) yang dimodifikasi)

Menurut (Tomberlin & Sheppard, 2002) bahwa siklus hidup BSF dari telur hingga

menjadi lalat dewasa berlangsung sekitar 40-43 hari, tergantung dari kondisi

lingkungan dan media pakan yang diberikan (gambar 2.2). Lalat betina akan

meletakkan telurnya di dekat sumber pakan, antara lain pada bongkahan kotoran unggas atau ternak, tumpukan limbah bungkil inti sawit (BIS) dan limbah organik

lainnya. Lalat betina tidak akan meletakkan telur di atas sumber pakan secara

langsung dan tidak akan mudah terusik apabila sedang bertelur.

Seekor lalat betina BSF normal mampu memproduksi telur berkisar 185-1235 telur.

(Rachmawati et al., 2015). Literatur lain menyebutkan bahwa seekor betina

memerlukan waktu 20-30 menit untuk bertelur dengan jumlah produksi telur antara

546-1.505 butir dalam bentuk massa telur (Tomberlin & Sheppard 2002). Berat

massa telur berkisar 15,8-19,8 mg dengan berat individu telur antara 0,026-0,030

mg. Waktu puncak bertelur dilaporkan terjadi sekitar pukul 14.00-15.00. Lalat

betina dilaporkan hanya bertelur satu kali selama masa hidupnya, setelah itu mati.

(Tomberlin & Sheppard, 2002).

Suhu merupakan salah satu faktor yang berperan dalam siklus hidup BSF. Suhu

yang lebih hangat atau di atas 30°C menyebabkan lalat dewasa menjadi lebih aktif

dan produktif. Suhu optimal larva untuk dapat tumbuh dan berkembang adalah

30°C, tetapi pada suhu 36°C menyebabkan pupa tidak dapat mempertahankan

hidupnya sehingga tidak mampu menetas menjadi lalat dewasa. Pemeliharaan larva

dan pupa BSF pada suhu 27°C berkembang empat hari lebih lambat dibandingkan

dengan suhu 30°C. (Tomberlin et al., 2009). Suhu juga berpengaruh terhadap masa

inkubasi telur. Suhu yang hangat cenderung memicu telur menetas lebih cepat

dibandingkan dengan suhu yang rendah. Selain itu, kelembaban juga dilaporkan

berpengaruh terhadap daya bertelur lalat BSF. Sekitar 80% lalat betina bertelur

pada kondisi kelembaban lebih dari 60% dan hanya 40% lalat betina yang bertelur

ketika kondisi kelembaban kurang dari 60% (Tomberlin & Sheppard, 2002).

Seperti yang terlihat pada gambar 2.2, lalat dewasa akan bertahan setidaknya 3 hari

sebelum mereka mati dalam kondisi tidak makan dan minum. Meskipun lalat

dewasa tidak memerlukan pakan sepanjang hidupnya, tetapi pemberian air dan

madu dilaporkan mampu memperpanjang lama hidup dan meningkatkan produksi

telur. (Rachmawati et al., 2015) membuktikan bahwa puncak kematian lalat dewasa

yang diberi minum madu terjadi pada hari ke-10 hingga 11, sedangkan pada lalat

yang diberi minum air terjadi kematian tertinggi pada hari kelima hingga kedelapan

dan berlanjut pada hari ke-10 hingga 12. Ditinjau dari waktu bertelurnya, lalat betina yang diberi minum madu mencapai puncak waktu bertelur pada hari kelima,

sedangkan pada perlakuan pemberian air terjadi pada hari ketujuh.

Aktivitas kawin BSF umumnya terjadi pada pukul 8.30 dan mencapai puncaknya

pada pukul 10.00 di lokasi yang penuh tanaman (vegetasi) ketika suhu lingkungan

mencapai 27°C. Lalat betina hanya kawin dan bertelur sekali selama masa

hidupnya. Saat melakukan aktivitas kawin, lalat jantan akan memberikan sinyal ke

lalat betina untuk datang ke lokasi yang telah ditentukan oleh pejantan. Perkawinan

BSF terjadi di tanah dengan posisi jantan dan betina berlawanan (saling

membelakangi) atau di daerah yang penuh dengan vegetasi. Namun, ada juga

laporan yang menyebutkan bahwa perkawinan dapat juga terjadi di udara.

(Wardhana et al., 2016).

Umumnya lalat dewasa membutuhkan penerangan yang tinggi tetapi masih di

bawah intensitas sinar matahari. Minimal intensitas cahaya yang dibutuhkan untuk

aktivitas kawin adalah 70 µmol m-2 s-1, sedangkan puncak aktivitas kawin terjadi

pada kondisi penerangan 100 µmol m-2 s-1 atau lebih dari 200 µmol m-2 s-1 hingga

500 µmol m-2 s-1 . (Sheppard et al., 2002).

Menurut situs (apogeeinstruments.com, 2016) Mikromol: per second and square

meter (µmol m-2 s-1). Istilah ini didasarkan pada jumlah photon dalam insiden

waveband tertentu per satuan waktu (s) pada satuan luas (m2) dibagi dengan konstanta Avogadro (6,022 x 10²³ mol⁻¹
). Ini biasanya digunakan untuk

menggambarkan Photosynthetic Active Radiation atau PAR dalam waveband 400-

700 nm (Thimijan, Richard W., et al. 2018:818-822). Untuk memudahkan

pembacaan, konversi nilai satuan 10 µmol m-2 s-1 setara dengan 540 lux. Jika

cahaya yang dibutuhkan minimal pada lalat untuk aktivitas kawin adalah 70 µmol

m-2 s-1 , maka intensitas cahaya yang diperlukan adalah ± 3780 lux (Sheppard et

al., 2002).

### 2.2.2. Internet of Things (IoT)

Internet of Things (IoT) merupakan sebuah konsep di mana suatu benda atau objek

ditanamkan teknologi-teknologi seperti sensor dan software dengan tujuan untuk

berkomunikasi, mengendalikan, menghubungkan, dan bertukar data melalui

perangkat lain selama masih terhubung ke internet (Setiawan, 2021b).

### 2.2.3. Bot telegram API

Bot adalah akun Telegram yang dioperasikan oleh program. Mereka dapat

menanggapi pesan atau sebutan, dapat diundang ke dalam grup, dan dapat

diintegrasikan dengan program lain. Bot juga dapat menerima pembayaran online

yang dilakukan dengan kartu kredit (Wikipedia.com, 2022b).


Gambar 2.3 The Botfather, layanan untuk membuat dan mengelola

akun bot telegram (Sumber : https://telegram.me/botfather)

Seperti ilustrasi pada gambar 2.3, telegram juga menawarkan Application

Programming Interface (API) melalui The Botfather yang memungkinkan

pengembang membuat akun bot yang dikendalikan oleh program. Berbagai bot

semacam itu digunakan di berbagai bidang sebagai contohnya, bot pernah

digunakan untuk memainkan game lama di aplikasi, memberi tahu pengguna

tentang ketersediaan vaksin untuk COVID-19 dan masih banyak lagi. Dalam

pengaplikasiannya, API dalam bot telegram akan dijadikan sebagai penjembatan

komunikasi antara mikrokontroler ESP32 dengan server di telegram. Bertujuan

agar user dapat menerima output data sekaligus mengirimkan perintah pada ESP32.

### 2.2.4. Mikrokontroler ESP32


Gambar 2.4 ESP32 Mikrokontroler dengan external antenna

(Sumber : https://tokopedia.link/6e1K2JgBoub)

ESP32 pada gambar 2.4 adalah serangkaian sistem low cost dan low power pada

mikrokontroler chip dengan Wi-Fi terintegrasi dan Bluetooth mode ganda. ESP32

dibuat dan dikembangkan oleh Espressif Systems, sebuah perusahaan Cina yang

berbasis di Shanghai, dan diproduksi oleh (Taiwan Semiconductor Manufacturing

Company) | TSMC | menggunakan | proses | 40 | nm | (nanometer) | mereka

(Wikipedia.com, 2022a).

Mikrokontroler ini memiliki fungsi untuk mengontrol segala lalu lintas data

komunikasi yang bersumber dari sensor dan aktuator sebagai kendali terhadap

perangkat terkendali.

### 2.2.5. Sensor Intensitas Cahaya BH1750


Gambar 2.5 Sensor BH1750 (Sumber : https://tokopedia.link/wxJ0pAOjsub)

BH1750 adalah sensor cahaya ambient digital pada gambar 2.5 yang biasa

digunakan pada ponsel untuk memanipulasi kecerahan layar berdasarkan

pencahayaan lingkungan. Sensor ini dapat secara akurat mengukur nilai LUX

cahaya hingga 65535 lux (Components101.com, 2019).

Sensor ini digunakan untuk mendeteksi intensitas cahaya yang berada di sekitar

kandang lalat, dengan mengacu pada nilai sensor tersebut, dapat dikalkulasi berapa

besar intensitas lampu yang dibutuhkan untuk menstimulasi lalat agar memproduksi

telur dengan jumlah yang optimal.

### 2.2.6. Digital Lux Light Meter

Alat Ini adalah alat yang digunakan untuk mengukur nilai intensitas cahaya seperti

halnya sensor BH1750. Alat ini digunakan untuk mencocokan dan mengkalibrasi

nilai lux yang terekam pada sensor BH1750 yang terdapat pada gambar 2.6.


Gambar 2.6 Digital Lux Light Meter

(Sumber : https://tokopedia.link/Zfh7rXamsub)

### 2.2.7. Sensor Suhu DHT11

DHT11 adalah sensor suhu dan kelembaban yang umum digunakan yang

dilengkapi dengan mikrokontroler 8-bit untuk menampilkan nilai suhu dan

kelembaban sebagai data serial (Components101.com, 2021). Seperti yang terlihat

pada gambar 2.7, DHT11 memiliki warna biru dan memiliki 4 kaki pin.


Gambar 2.7 Sensor DHT11 (Sumber : https://tokopedia.link/hOzuF1Cosub)

Dalam penerapannya, DHT11 ini bersama dengan BH1750 akan menjadi faktor

penentu apakah perlu menyalakan lampu fertilizer di saat kondisi kandang lalat

membutuhkannya, misalnya saat suhu dingin atau intensitas saat cahaya redup.

### 2.2.8. Temperature Meter


Gambar 2.8 Alat ukur temperatur (Sumber :

https://www.tokopedia.com/anugerahmed-mlg/thermometer-hygrometer-digital-

htc1-thermometer-untuk-suhu-ruangan)

Berfungsi sebagai alat ukur suhu dalam bentuk digital. Sama halnya dengan digital

lux light meter, temperature meter akan dijadikan sebagai pencocok antara

pembacaan sistem dengan pembacaan pada alat ukur ini dalam satuan celsius.

Seperti yang tertera pada gambar 2.8 ini merupakan contoh alat ukur temperatur

yang bertipe thermo gun.

### 2.2.9. NTP (Network Time Protocol)


Gambar 2.9 Alat ukur temperatur (Sumber :

https://vandelaybrands.com/products/vandelay-infrared-thermometer)

Network Time Protocol gambar 2.9 adalah kependekan dari NTP yang merupakan

protokol jaringan untuk sinkronisasi jam antara sistem komputer. Dengan kata lain,

ini digunakan untuk menyinkronkan waktu jam komputer dalam jaringan. Ada

server ntp yang dapat digunakan siapa saja untuk meminta waktu sebagai klien.

Dalam hal ini, ESP32 adalah klien ntp yang meminta waktu dari ntp server

pool.ntp.org (Santos & Santos, 2020).

### 2.2.10. USB Charger


Gambar 2.10 Kepala USB charger dual-ports

USB Charger pada gambar 2.10 berfungsi sebagai catu daya untuk menyalakan

mikrokontroler ESP3. Alasan untuk memilih ini adalah tegangan dan arus yang

dikeluarkan merupakan regulated power, dimana tegangan yang didapat adalah 5V

dan arus yang daya yang dapat diambil sekitar 18-20Watt secara flat tanpa perlu

takut akan terjadinya lonjakan tegangan atau daya secara tiba – tiba.

### 2.2.11. Relay


Gambar 2.11 Relay 4 – channel

Relay pada gambar 2.11 adalah sebuah switch atau saklar yang dioperasikan secara

Electromechanical (Elektromekanikal) yang terdiri dari 2 bagian utama yakni

bagian coil dan mekanikal (Kho, 2015). Relay menggunakan prinsip

elektromagnetik untuk menggerakkan kontak saklar sehingga dengan arus listrik

yang kecil dapat menghantarkan listrik yang bertegangan lebih tinggi. Sebagai

contoh, dengan relay yang menggunakan tegangan 5V mampu menggerakan

Armature Relay (yang berfungsi sebagai saklarnya) untuk menghantarkan listrik

220V 2A (Kho, 2015). Pada penerapannya, relay ini akan digunakan untuk

mengontrol saklar pada water pump dan lampu fertilizer.

### 2.2.12. Plain PCB


Gambar 2.12 Plain PCB

Pada gambar 2.12 merupakan sebuah plain PCB atau yang sering disebut dengan

dot matrix PCB. Tujuan menggunakan PCB ini ialah untuk mengumpulkan

komponen - komponen yang dapat dikumpulkan didalam panel box elektrik.

Setelah itu, semua komponen yang terpasang barulah dapat dikuatkan dengan

proses soldering.

### 2.2.13. Panel Box


Gambar 2.13 Panel box elektronika

Panel box sendiri pada gambar 2.13 sering digunakan sebagai tempat penyimpanan

yang digunakan untuk menyimpan komponen aktif elektronika. Komponen –

komponen yang sekiranya muat untuk dikumpulkan di panel box akan dimasukkan

kedalamnya dengan tambahan plain PCB sebagai tempat untuk menghubungkan

antar komponen.

### 2.2.14. Toggle Switch


Gambar 2.14 Toggle Switch 1021

Toggle switch pada gambar 2.14 merupakan perantara untuk memutuskan atau

menyambungkan arus listrik pada sebuah rangkaian, sehingga rangkaian dapat

berfungsi bila saklar dalam posisi ON, sedangkan ketika posisi OFF maka

rangkaian akan berhenti berfungsi. Adapun jenis yang digunakan merupakan Single

Position, Single Throw (SPST) jenis saklar toggle paling sederhana. Satu sisi adalah

terminal input, dan sisi lain adalah terminal output. Di satu posisi sakelar dalam

kondisi open dan tidak ada koneksi yang dibuat, dan tidak ada daya yang dapat

mengalir ke alat. Di posisi lain kedua terminal terhubung dan arus dapat dialirkan

(rangkaianelektronika.info, 2019).

### 2.2.15. LCD


Gambar 2.15 LCD 20x4

Liquid Crystal Display atau LCD pada gambar 2.15 adalah suatu jenis media

display (tampilan) yang menggunakan kristal cair (liquid crystal) untuk

menghasilkan gambar yang terlihat. Teknologi LCD sudah banyak digunakan pada

produk-produk seperti layar Laptop, layar Ponsel, layar Kalkulator, layar Jam

Digital, layar Multimeter, Monitor Komputer, Televisi, layar Game portabel, layar

Thermometer Digital dan produk-produk elektronik lainnya (Kho, 2018).

### 2.2.16. Pompa DC 12 V 130Psi


Gambar 2.16 Pompa air high pressure

Pompa air pada gambar 2.16 ini merupakan pompa air bertekanan tinggi yang

mampu mengalir air dengan tekanan 130Psi (Pound per square inch) yang

ditenagai dengan catu daya sebesar 12VDC, 60Watt. Output dari pompa air ini

berbentuk seperti kabut atau mist yang sering terlihat pada tempat pencucian

kendaraan bermotor.

### 2.2.17. MiFi 4G LTE


Gambar 2.16 MiFi Huawei

Mobile WiFi atau MiFi pada gambar 2.16 merupakan sebuah perangkat penyedia

koneksi internet portabel yang menggunkaan koneksi broadband berbasis simcard

sebagai jalur komunikasi ke internet. Dengan ketersediaan koneksi tersebut, data

yang berada pada mikrokontroler ESP32 dapat dikirimkan ke server telegram dan

dapat menerima perintah dari pesan bot telegram.

### 2.2.18. Lampu Fertilizer


Gambar 2.17 Grow Light (Sumber:

https://www.thisoldhouse.com/gardening/22621681/best-led-grow-light)

Penyebutan Lampu Fertilizer berawal dari tujuan awal lampu ini yaitu “fertilize”

atau yang bermakna menyuburkan. Pada gambar 2.17, penerapan lampu ini

digunakan di kalangan botanis yang menggunakan lampu grow light yang

didalamnya terdapat kombinasi spektrum warna biru dan merah yang digabungkan.

Disaat lampu tersebut dipancarkan akan memunculkan warna ungu dengan sebutan

ultraviolet yang dimana lampu tersebut secara artifical dapat mempengaruhi

pertumbuhan makhluk hidup seperti tanaman (waveformlighting.com, 2018).

Dikarenakan serangga memiliki karakteristik yang sama saat terpapar cahaya,

menjadikan grow light ini dipilih menjadi lampu fertilizer yang secara teknis

dengan intensitas cahaya yang tinggi dapat mempengaruhi aktivitas reproduksi

lalat. Sehingga, diharapkan dapat meningkatkan hasil produksi telur lalat BSF.

BAB III

RANCANGAN SISTEM

### 3.1. Rancangan Sistem

Pada bab ini, masuk ke rancangan sistem dimana akan dijelaskan bagaimana sistem

yang akan dibuat melalui tahap perancangan, implementasi, pengujian dan hasil

sesuai dengan metode penelitian SDLC model waterfall (Setiawan, 2021a) pada bab

I, sub-bab 1.5.

### 3.2. Perancangan

### 3.2.1. Desain Sistem Keseluruhan


Gambar 3.1 Desain sistem keseluruhan (Dok. Penulis)

Pada gambar 3.1 diketahui bahwa terdapat 2 network yang berbeda. 2 network ini

sama – sama akan menuju tujuan yang sama yaitu grup telegram melalui jalur

internet backbone masing – masing melalui koneksi WiFi. Prototipe sistem

mengirim dan menerima data dari perintah bot telegram menggunakan data string

yang diubah menjadi format JavaScript Object Notation atau JSON agar mudah

untuk dilakukan tahap parsing. Parse sendiri merupakan proses pembacaan format

JSON yang dapat dilakukan baik dari server-side ataupun client-side yang

kompatibel dengan berbagai macam bahasa pemrograman terutama C++.

Secara senderhana, dengan dibuatnya telegram group yang terintegrasi dengan

adanya bot telegram dapat memudahkan Peternak lalat BSF dan anggota grup untuk

saling berdiskusi dengan melakukan fitur bawaan aplikasi telegram untuk chatting,

uploading files, polling, voice note dan ditambah dengan integrasi bot telegram

commands untuk melakukan pemantauan kondisi suhu, kelembapan, intensitas

cahaya, mengatur water pump dan lampu fertilizer baik secara manual maupun

dengan automatic scheduling.
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
