setiyadi-ben/Project-Tugas-Akhir/tugas_akhir/dokumenTA/Syarat mendapatkan SKL.pdf

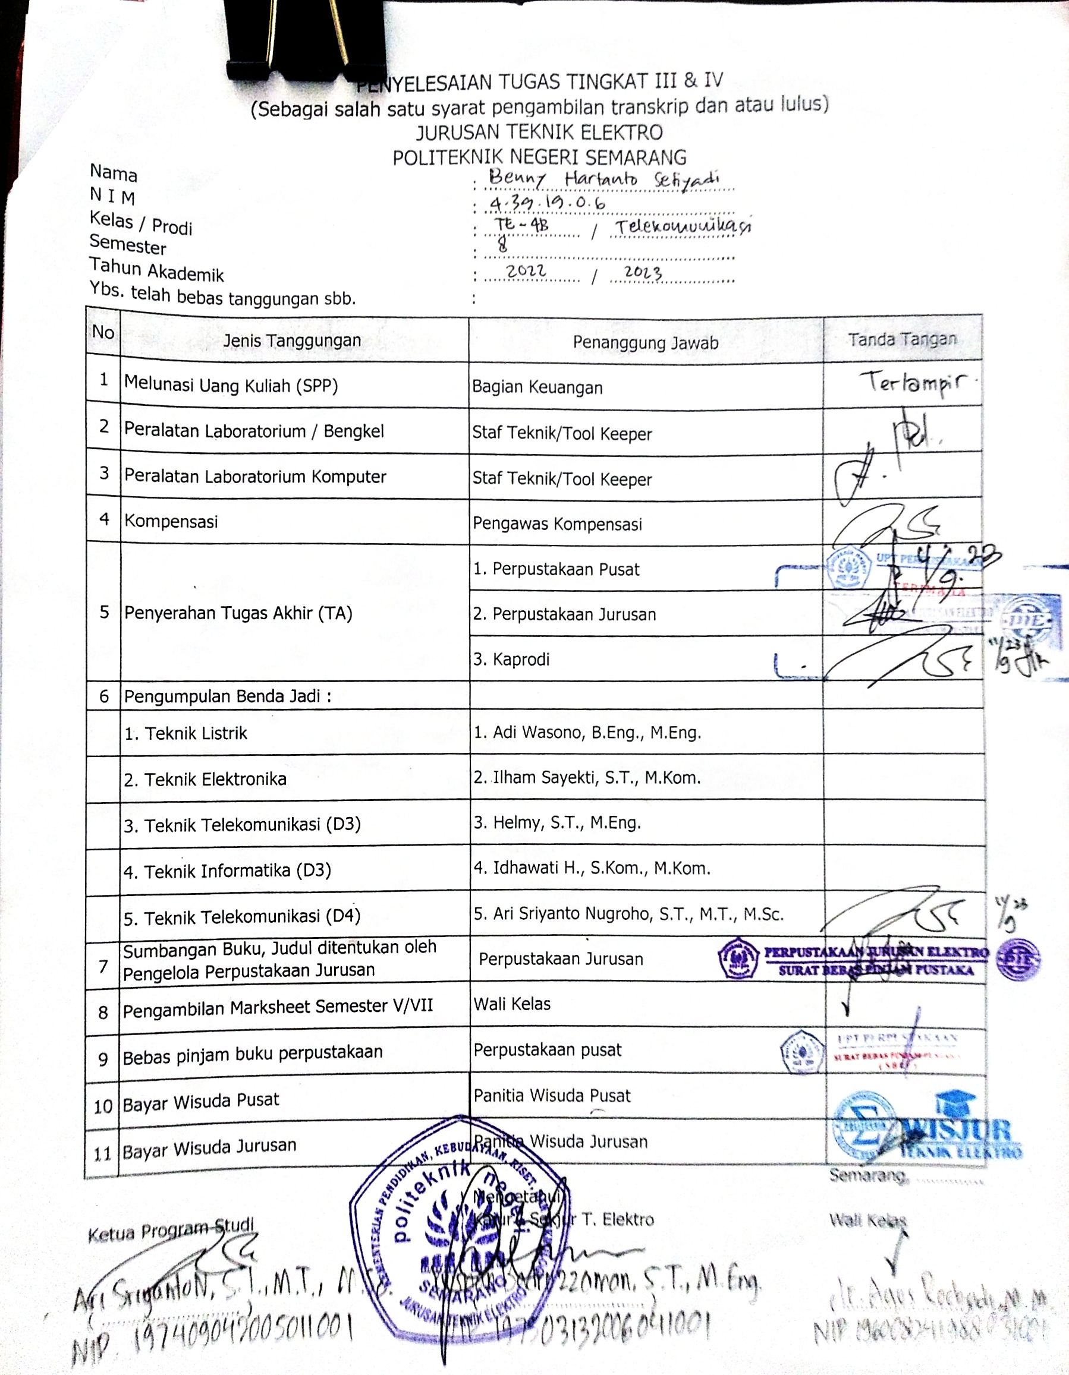
[picture p267: page 1]
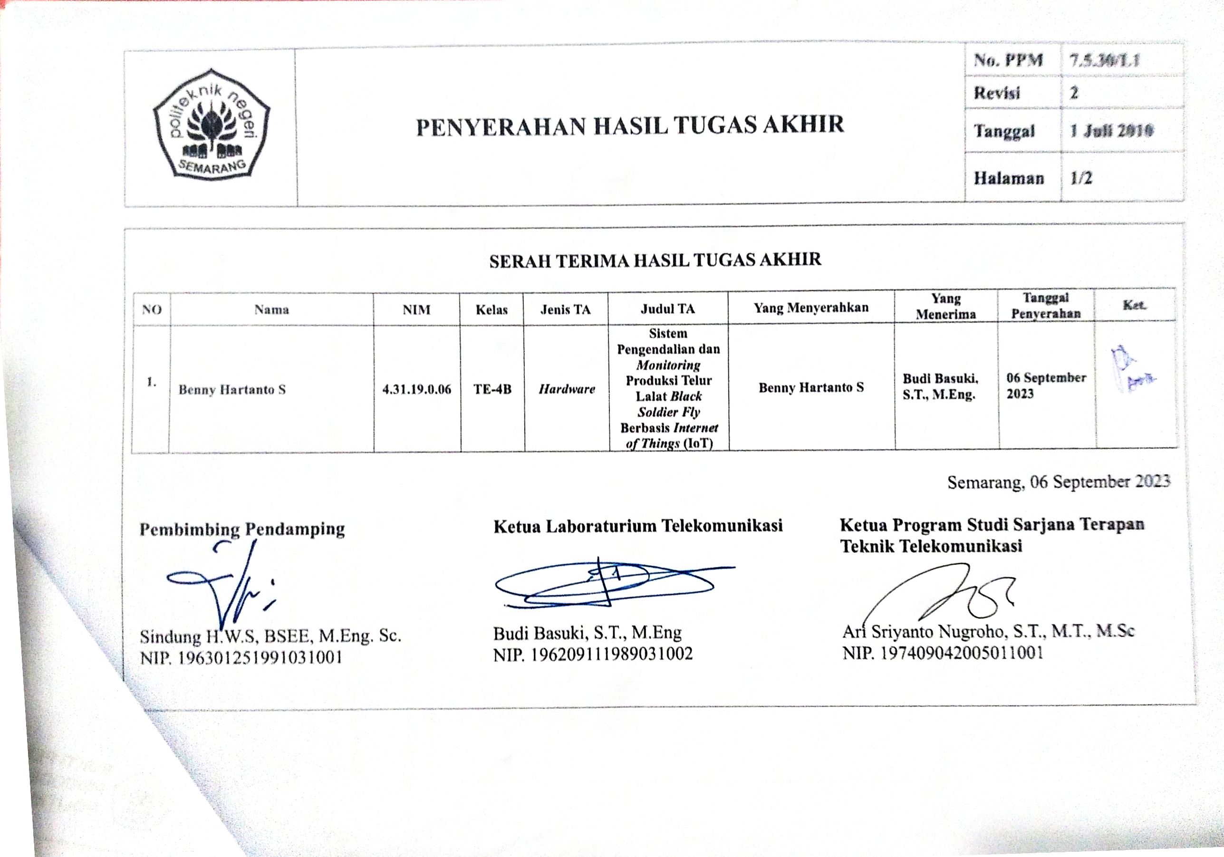
[picture p268: page 2]
