setiyadi-ben/Project-Tugas-Akhir/tugas_akhir/dokumenTA/berkasRevisi_TA.pdf

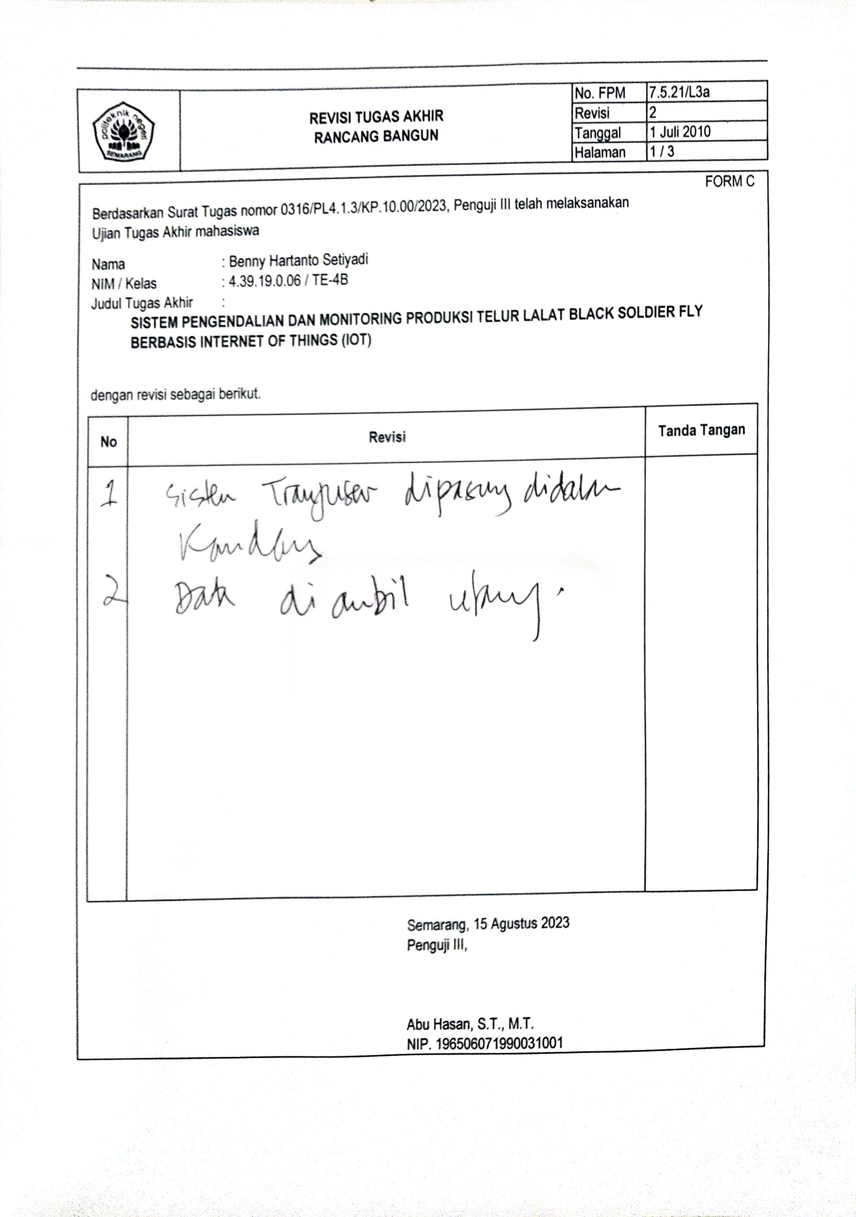
[picture p269: page 1]
