setiyadi-ben/Project-Tugas-Akhir/tugas_akhir/dokumenTA/Surat Tugas Ujian TA_Benny.pdf

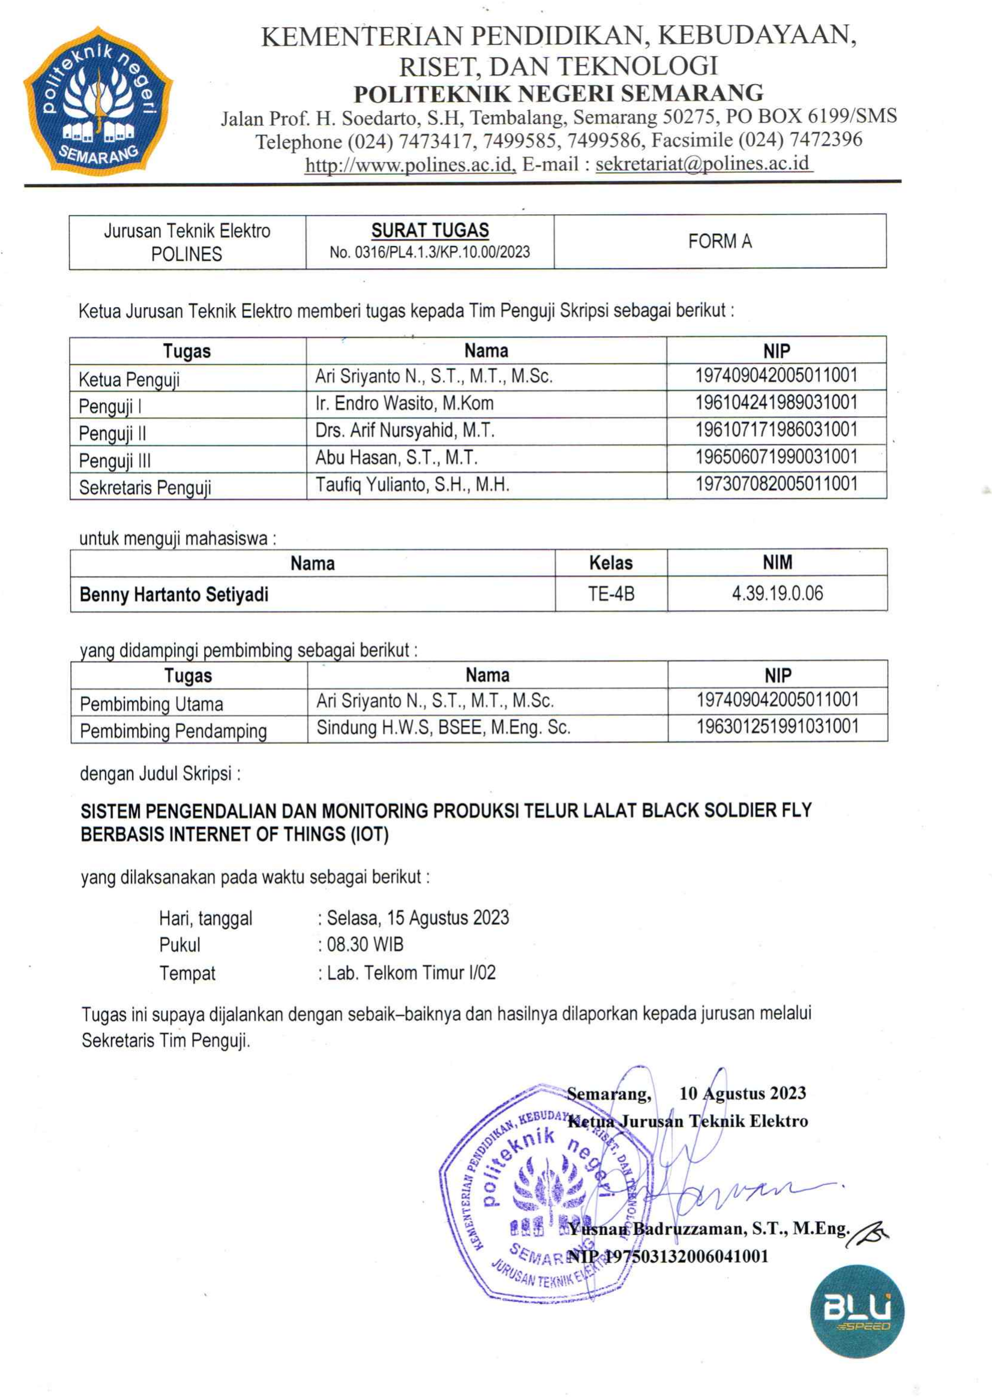
[picture p270: page 1]
