setiyadi-ben/Project-Tugas-Akhir/tugas_akhir/dokumenTA/Syarat Daftar Sertifikasi.pdf

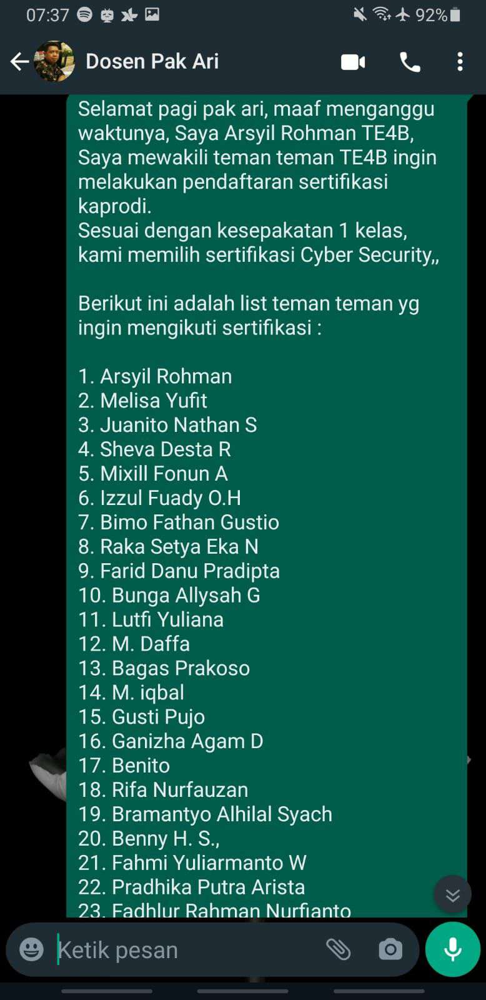
[picture p271: page 1]
