setiyadi-ben/Project-Tugas-Akhir/tugas_akhir/dokumenTA/daftarWisuda/bebas pinjam perpus.pdf

UPT PERPUSTAKAAN

POLITEKNIK NEGERI SEMARANG

KARTU BEBAS PINJAM PUSTAKA

NIM | : 4.39.19.0.06
Nama | : Benny Hartanto Setiyadi
Prodi | : Teknik Telekomunikasi
Surat ini diberikan kepada pemohon yang telah menyelesaikan semua urusan. sebagai berikut:
1. Denda
2. Pengembalian Buku

Sebagai syarat:

## PENGAMBILAN IJASAH

| Semarang, 04-September-2023 Mengetahui, Ka. UPT Perpustakaan

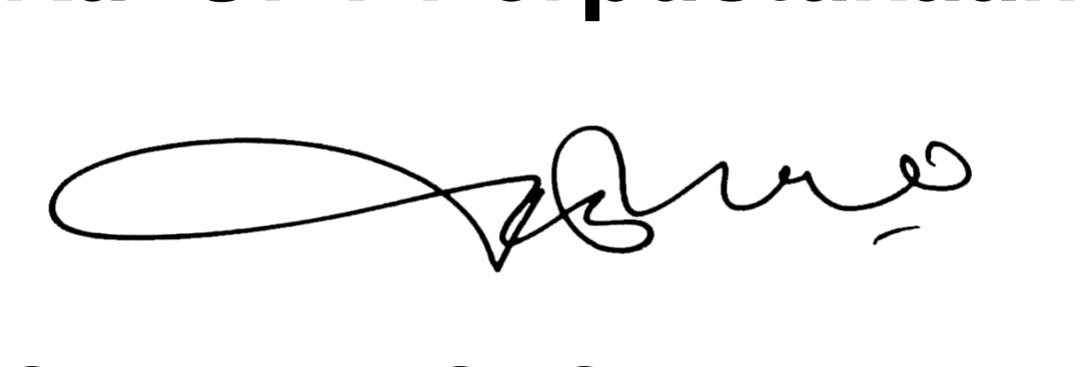
[picture p272: figure]

Suwarno S. Sos, M.I.Kom
NIP. 197810232001121001
