setiyadi-ben/Project-Tugas-Akhir/tugas_akhir/dokumenTA/contohKandangBSF1.jpeg

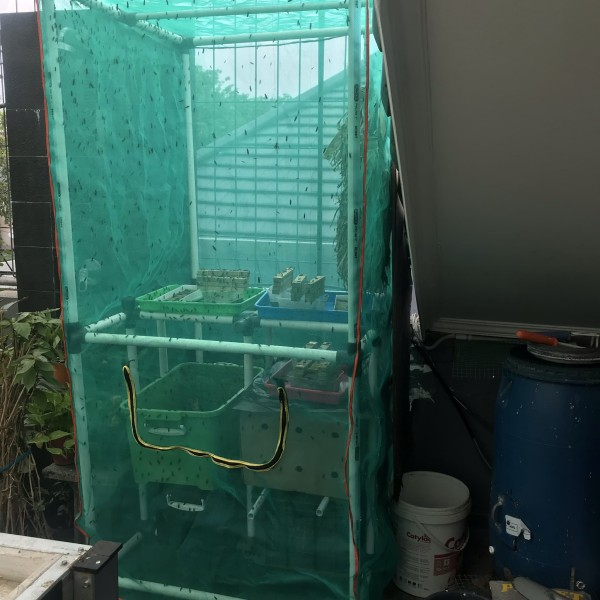
tugas_akhir/dokumenTA/contohKandangBSF1.jpeg
