setiyadi-ben/Project-Tugas-Akhir/tugas_akhir/dokumenTA/contohKandangBSF2.jpeg

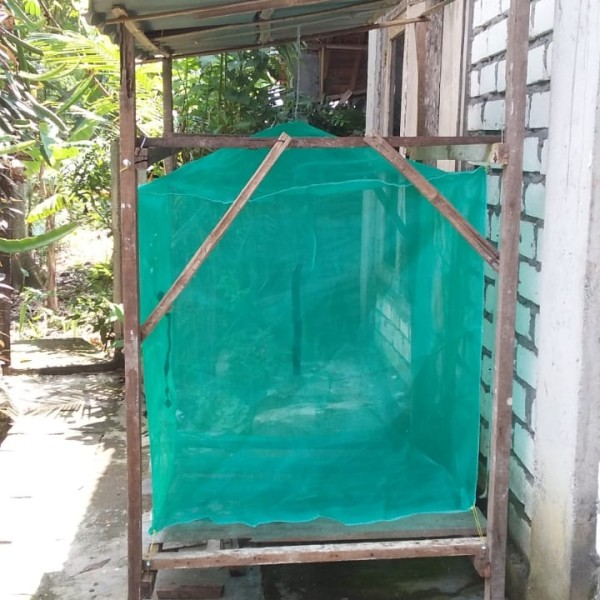
tugas_akhir/dokumenTA/contohKandangBSF2.jpeg
