setiyadi-ben/Project-Tugas-Akhir/tugas_akhir/dokumenTA/daftarWisuda/COVER CD.png

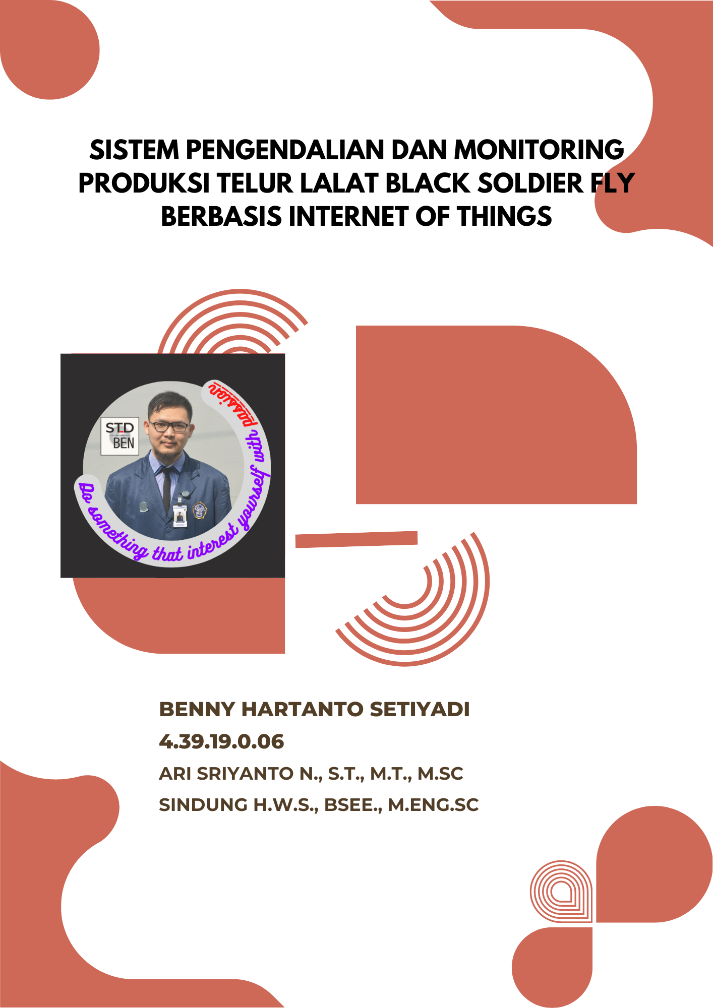
tugas_akhir/dokumenTA/daftarWisuda/COVER CD.png
