setiyadi-ben/Project-Tugas-Akhir/tugas_akhir/dokumenTA/radiocoverage.png

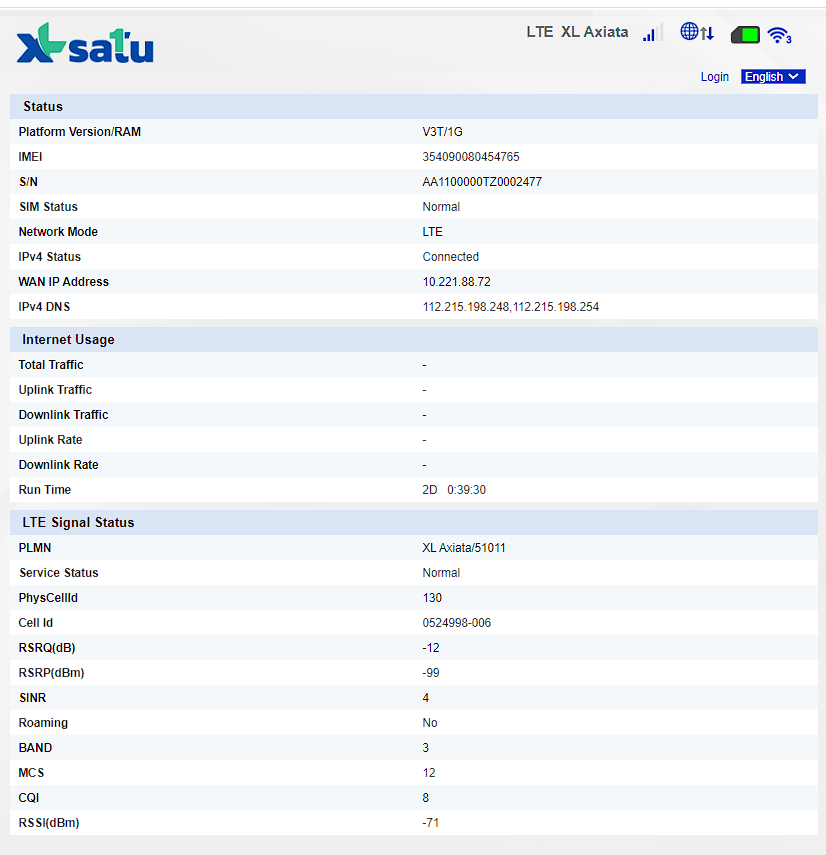
tugas_akhir/dokumenTA/radiocoverage.png
