setiyadi-ben/Project-Tugas-Akhir/tugas_akhir/dokumenTA/revised/monitoring telegram terbaru.png

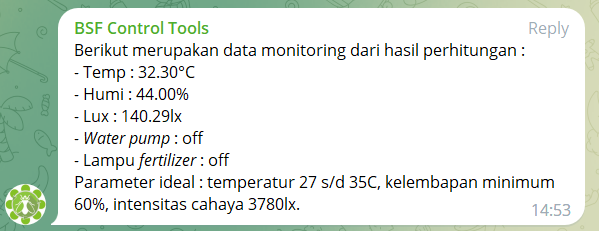
tugas_akhir/dokumenTA/revised/monitoring telegram terbaru.png
