setiyadi-ben/Project-Tugas-Akhir/tugas_akhir/dokumenTA/revised/revisi foto/photo_2023-08-23_07-54-12.jpg

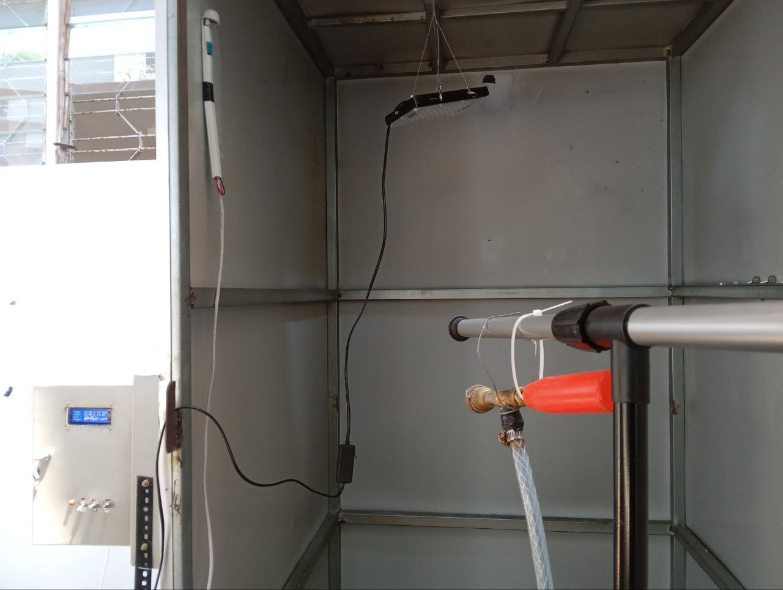
tugas_akhir/dokumenTA/revised/revisi foto/photo_2023-08-23_07-54-12.jpg
