setiyadi-ben/Project-Tugas-Akhir/tugas_akhir/dokumenTA/revised/revisi foto/photo_2023-08-23_07-54-21.jpg

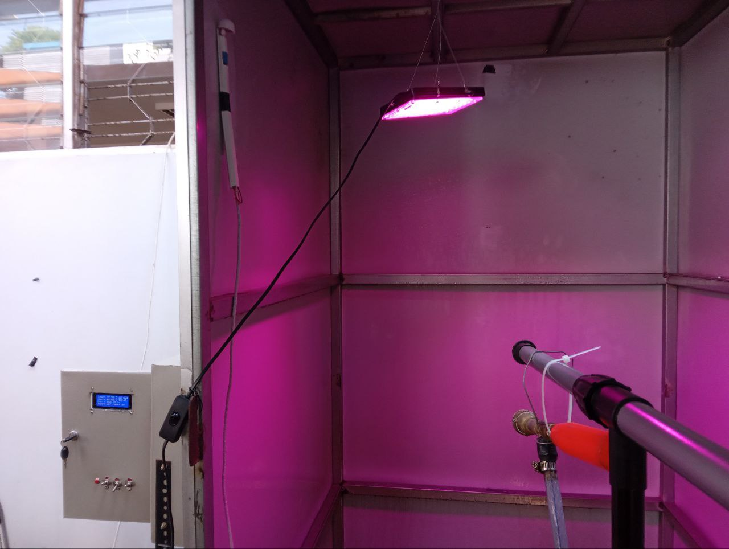
tugas_akhir/dokumenTA/revised/revisi foto/photo_2023-08-23_07-54-21.jpg
