setiyadi-ben/Project-Tugas-Akhir/tugas_akhir/dokumenTA/revisiSidang_parameterMonitoring.png

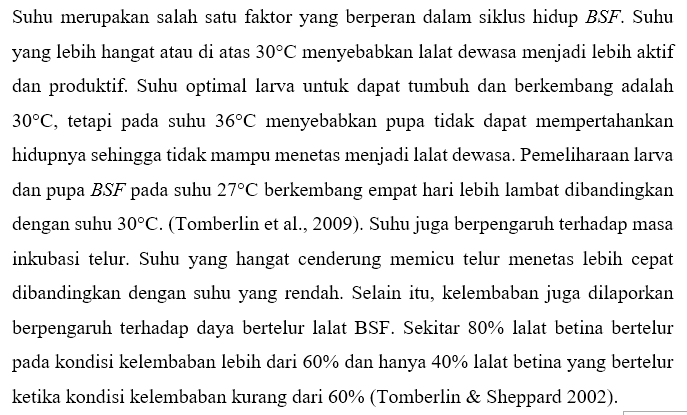
tugas_akhir/dokumenTA/revisiSidang_parameterMonitoring.png
