setiyadi-ben/Project-Tugas-Akhir/tugas_akhir/dokumenTA/sampel BH1750 & Mini light meter/WhatsApp Image 2023-08-04 at 15.40.02.jpeg

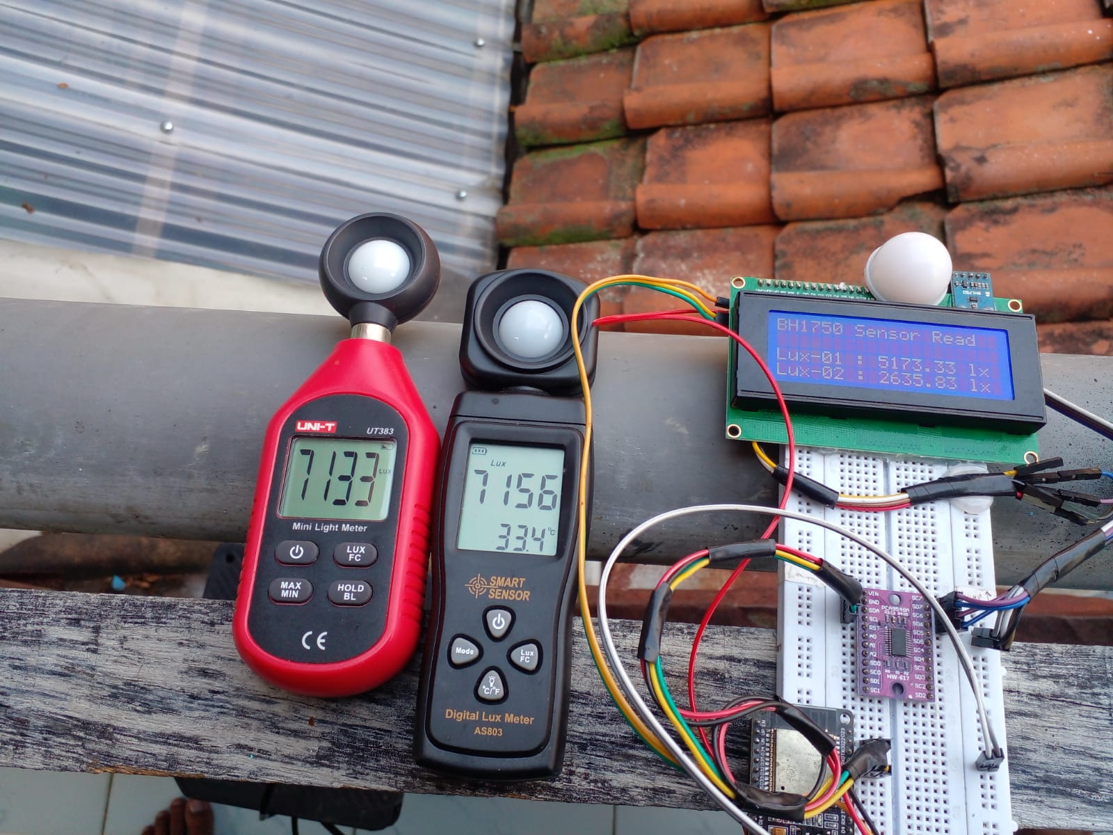
tugas_akhir/dokumenTA/sampel BH1750 & Mini light meter/WhatsApp Image 2023-08-04 at 15.40.02.jpeg
