setiyadi-ben/Project-Tugas-Akhir/tugas_akhir/dokumenTA/Syarat Daftar Sidang.jpeg

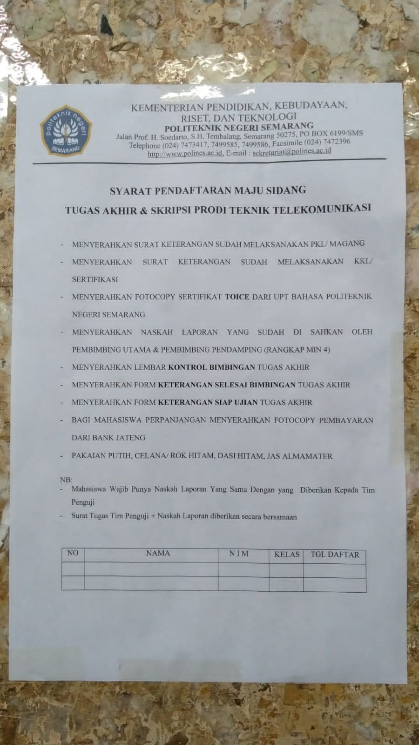
tugas_akhir/dokumenTA/Syarat Daftar Sidang.jpeg
