setiyadi-ben/Project-Tugas-Akhir/tugas_akhir/dokumenTA/Syarat Daftar Wisuda.jpeg

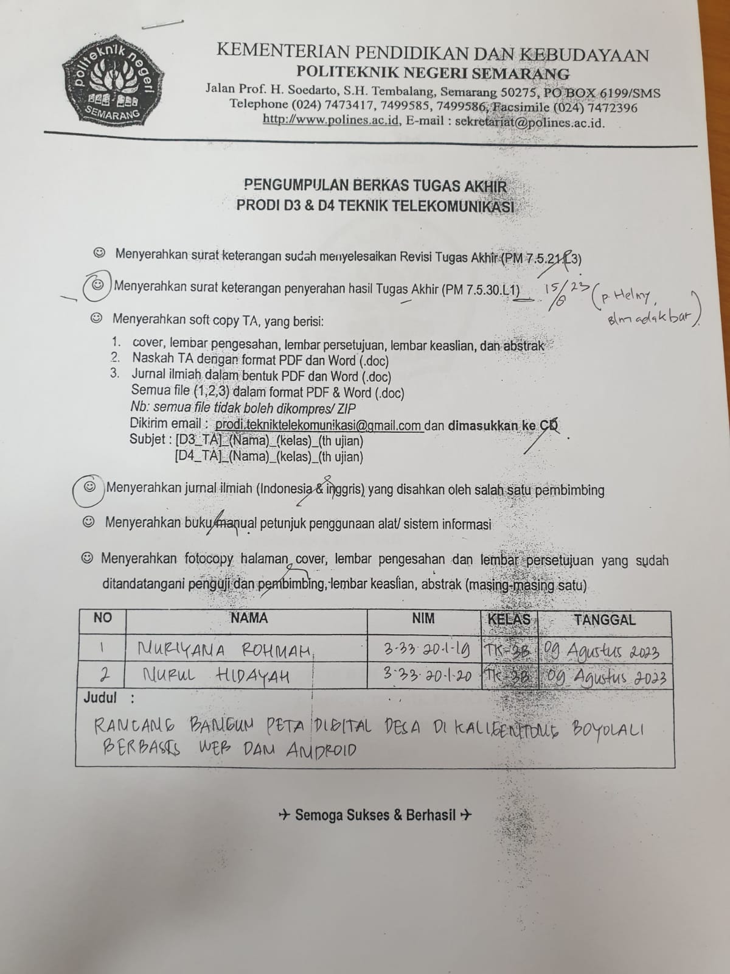
tugas_akhir/dokumenTA/Syarat Daftar Wisuda.jpeg
