setiyadi-ben/Project-Tugas-Akhir/tugas_akhir/datasheetKomponen/wiringDiagram.png

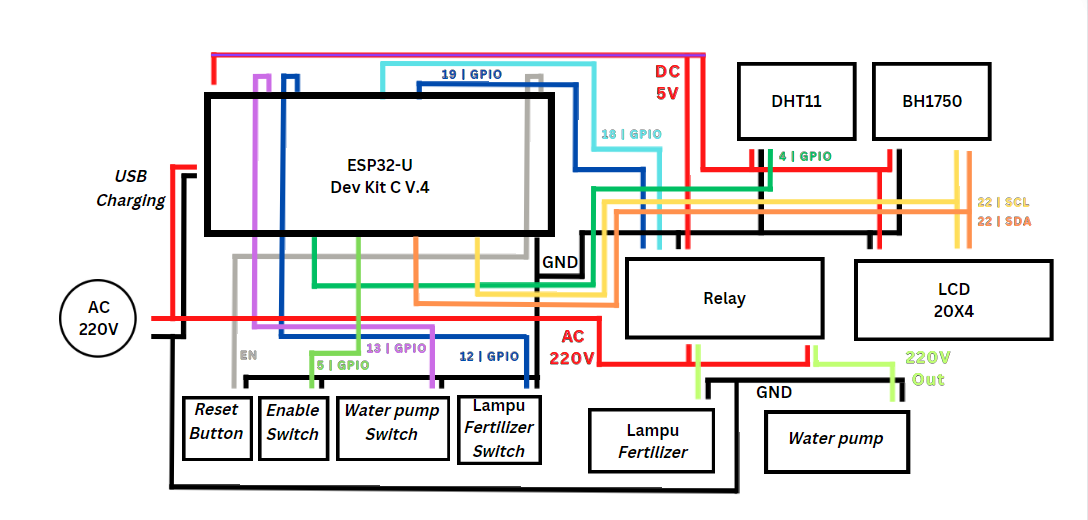
tugas_akhir/datasheetKomponen/wiringDiagram.png
