setiyadi-ben/Project-Tugas-Akhir/tugas_akhir/dokumenTA/daftarWisuda/COVER CD.pdf

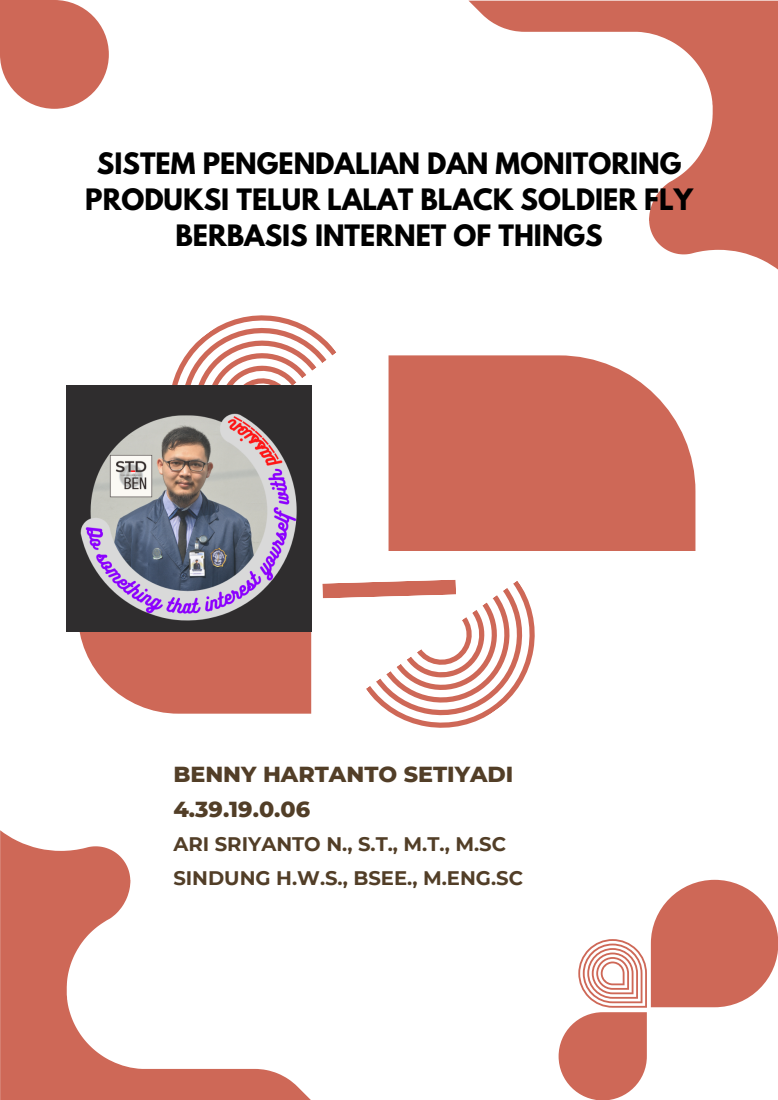
[picture p326: page 1]

SISTEM PENGENDALIAN DAN MONITORING
PRODUKSI TELUR LALAT BLACK SOLDIER FLY
BERBASIS INTERNET OF THINGS

BENNY HARTANTO SETIYADI
ARI SRIYANTO N., S.T., M.T., M.SC
SINDUNG H.W.S., BSEE., M.ENG.SC
