setiyadi-ben/Project-Tugas-Akhir/tugas_akhir/dokumenTA/revised/data-pengujianbsf-1.pdf

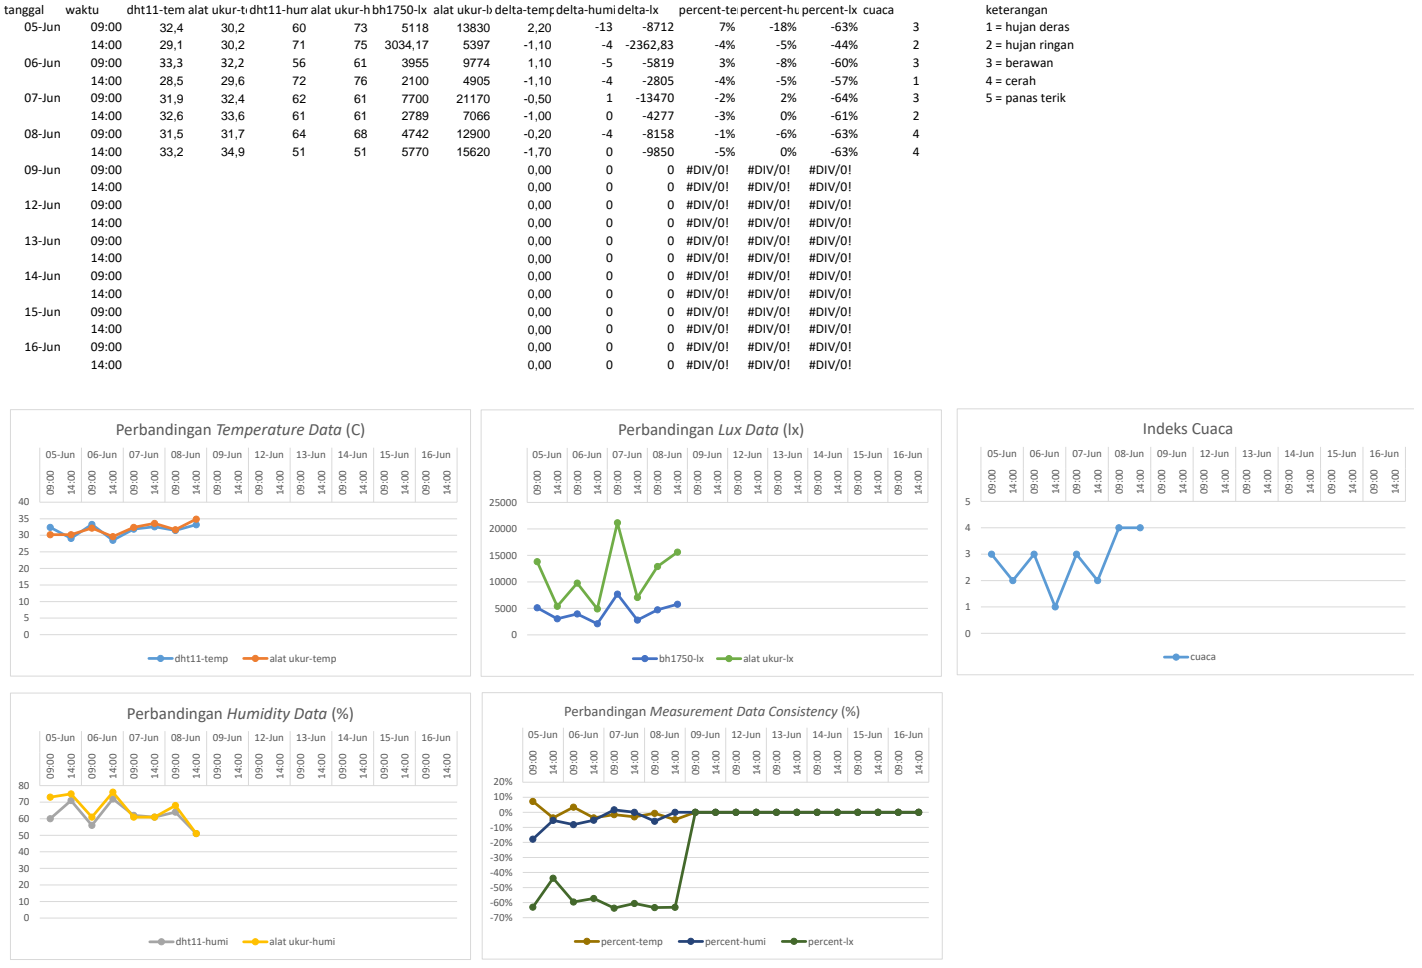
[picture p327: page 1]
tanggal; waktu; dht11-tempalat ukur-temp dht11-humialat ukur-humi bh1750-lx alat ukur-lxdelta-tempdelta-humidelta-lx; percent-temppercent-humi percent-lx cuaca; keterangan; 05-Jun; 1 = hujan deras; 2 = hujan ringan; 06-Jun; 3 = berawan; 4 = cerah; 07-Jun; 5 = panas terik; 08-Jun; 09-Jun; 0 #DIV/0!; #DIV/0!; 12-Jun; 13-Jun; 14-Jun; 15-Jun; 16-Jun; dht11-temp; alat ukur-temp; dht11-humi; alat ukur-humi; alat ukur-lx; percent-temp; percent-humi; percent-lx; Indeks Cuaca; cuaca

Perbandingan Temperature Data (C)

Perbandingan Lux Data (lx)

Perbandingan Humidity Data (%)

Perbandingan Measurement Data Consistency (%)
