setiyadi-ben/Project-Tugas-Akhir/(commit log)

2022-12-08 prog-3_gabung dht11, bh1750 dan relay
2022-12-29 backup untuk gabungan sensor dan aktuator
2022-12-29 berhasil menghubungkan custom command dg esp32
2022-12-30 print sensorValue berhasil
2023-01-12 fixing error related to time
    [main.cpp]
2023-01-12 display short datetimes in lcd 20x4
    [main.cpp, timebackup.cpp]
2023-01-16 fixed conflicting sw btwen tgbot sw & gpio sw
    [main.cpp]
2023-01-19 revised flowchart design by lecturer I
2023-03-21 change board from devkit v1 to devkit v4
2023-03-21 last logic found - fixing scheduleEnabled
    [main.cpp]
2023-03-30 finishing bab 3 + adding esp32 dsheet
2023-04-08 fix a bug manual GPIO not working while inet off
    [main.cpp]
2023-05-16 redraw flowchart diagram
2023-05-18 dok-rev5 Bp Ari - blok, gambar, flowchart
2023-06-11 file - file pengujian week - 1
    [data-pengujianbsf-1.xlsx, dummy.csv]
2023-06-11 fixing aktuator untuk tidak menyala saat boot+more
    [main.cpp]
2023-06-14 new data input
    [data-pengujianbsf-1.xlsx]
2023-06-15 newi input data record
    [data-pengujianbsf-1.xlsx]
2023-06-15 found 2 bug, one clear and one more to solve
    [main.cpp]
2023-06-16 fixed telegram switch bug
    [main.cpp]
2023-06-16 various logic changes & bug fixed 2 of 2
    [main.cpp]
2023-06-19 beta, schedule aman tapi switch konflik
2023-06-19 keep schedule forget manual telegram switch
2023-07-16 revisi bimbingan 4
    [data-pengujianbsf-1.xlsx]
2023-07-19 backup tahap akhir - 1
    [data-pengujianbsf-1.xlsx]
2023-07-20 sisa bab 5 dan abstrak
    [data-pengujianbsf-1.xlsx]
2023-07-30 backup tahap akhir - 4 (lap TA revised)
    [data-pengujianbsf-2.xlsx]
2023-08-07 deleted unnecesarry files
    [data-pengujianbsf-2.xlsx]
2023-08-07 finalizing things untuk mendaftar sidang TA
    [DIPAKAI_data-pengujianbsf-2.xlsx]
2023-08-15 Branch Final TA sebelum revisi
    [DIPAKAI_data-pengujianbsf-2.xlsx, data-pengujianbsf-2.xlsx]
2023-08-17 berkas revisi sidang TA (alat dan laporan)
    [DIPAKAI_data-pengujianbsf-3.xlsx]
2023-08-18 logic hell. /print bocor & forget if else only 1
2023-08-18 simpling sensor read + add humidity stop cause
2023-09-17 Dokumentasi akhir setelah dinyatakan lulus
    [DIPAKAI_data-pengujianbsf-3.xlsx]
